szsamin/Nexys4DDRQuadcopter/README.md

# Nexys4DDRQuadcopter
Fully Functional Quadcopter over bluetooth control with RN42. We were not able to make the control system work well. But the basic functionality as all there.
