szsamin/Nexys4DDRQuadcopter/embsys.pdf

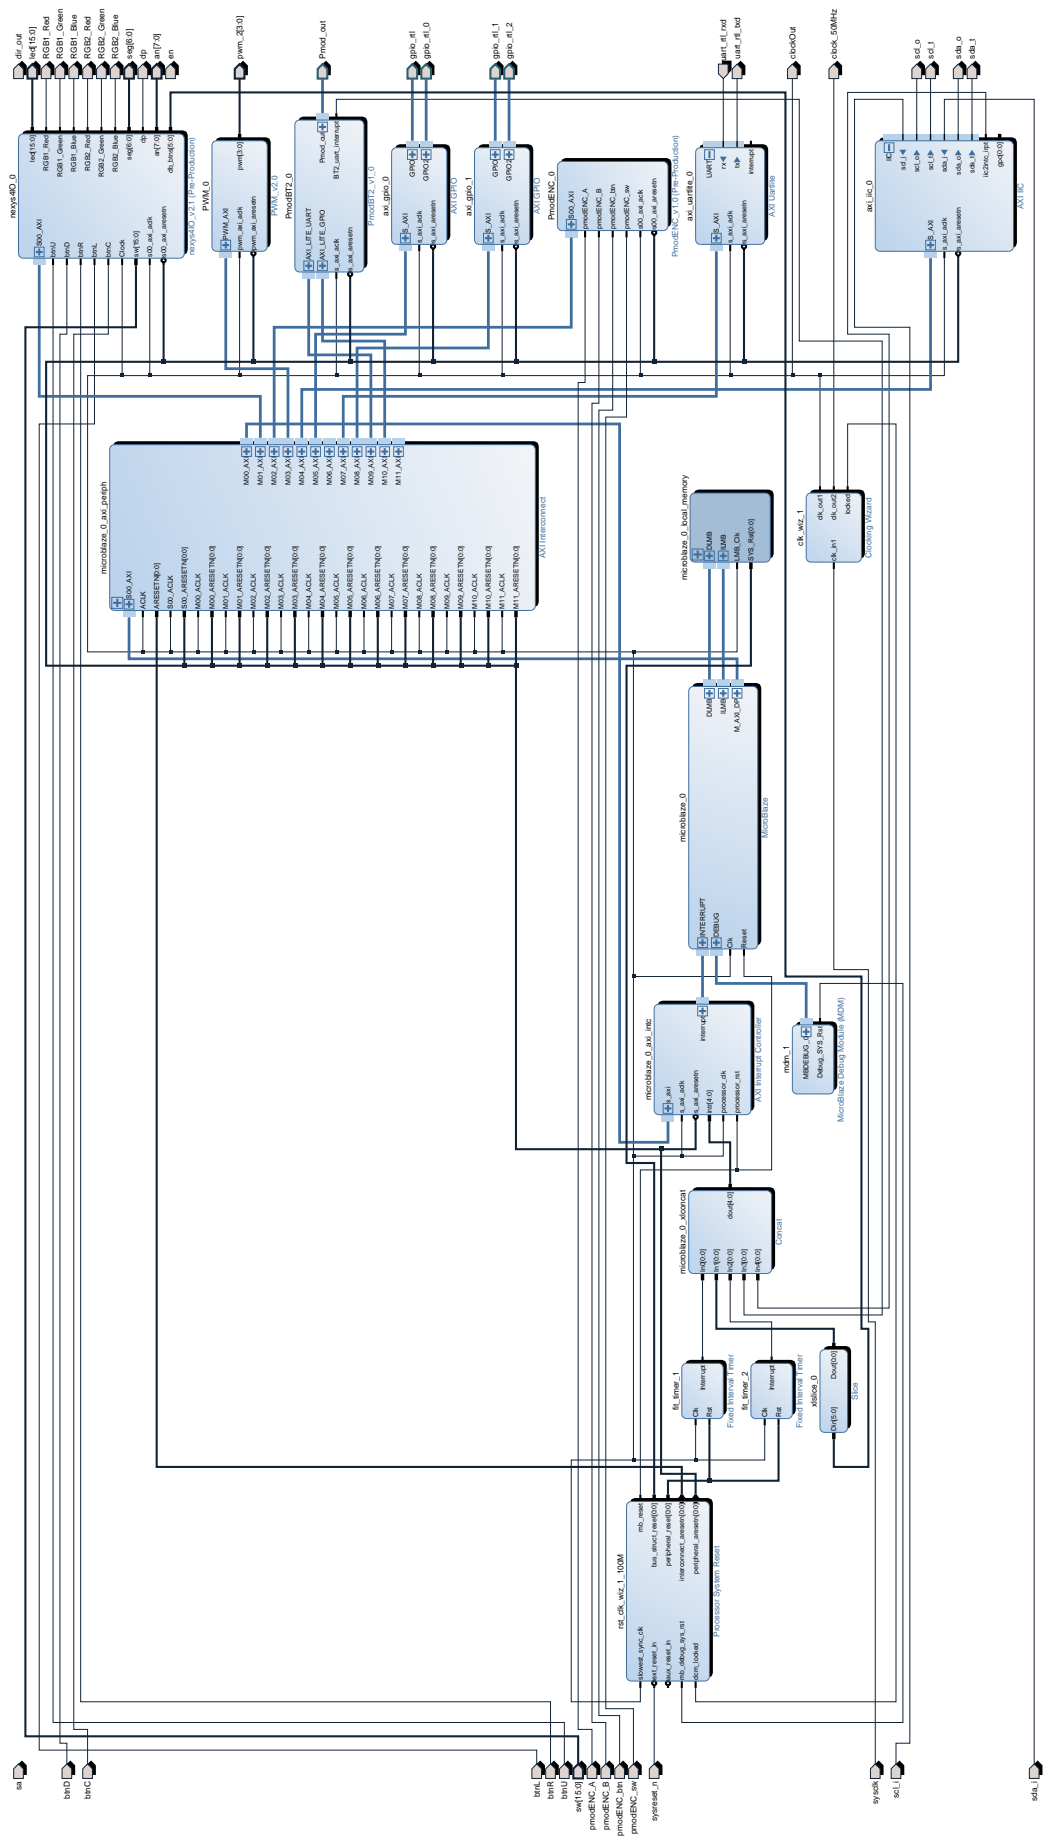
[picture p7: page 1]
PWM_0; PWM_v2.0; PWM_AXI; pwm[3:0] pwm_axi_aclk; pwm_axi_aresetn; PmodBT2_0; PmodBT2_v1_0; Pmod_out; AXI_LITE_UART; AXI_LITE_GPIO; BT2_uart_interrupt s_axi_aclk; s_axi_aresetn; PmodENC_0; PmodENC_v1.0 (Pre-Production); S00_AXI; pmodENC_A; pmodENC_B; pmodENC_btn; pmodENC_sw; s00_axi_aclk; s00_axi_aresetn; RGB1_Red RGB1_Green RGB1_Blue RGB2_Red RGB2_Green RGB2_Blue; axi_gpio_0; AXI GPIO; S_AXI GPIO; GPIO2; s_axi_aclk; axi_gpio_1; axi_iic_0; AXI IIC; S_AXI; IIC; scl_i; scl_o; scl_t; sda_i; sda_o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

MicroBlaze Debug Module (MDM)

AXI Interrupt Controller

Fixed Interval Timer

Processor System Reset
