szsamin/Nexys4DDRQuadcopter/sources_1/bd/embsys/hdl/embsys.v

//Copyright 1986-2016 Xilinx, Inc. All Rights Reserved.
//--------------------------------------------------------------------------------
//Tool Version: Vivado v.2016.2 (win64) Build 1577090 Thu Jun  2 16:32:40 MDT 2016
//Date        : Sat Mar 18 22:24:07 2017
//Host        : DESKTOP-9GRO23T running 64-bit major release  (build 9200)
//Command     : generate_target embsys.bd
//Design      : embsys
//Purpose     : IP block netlist
//--------------------------------------------------------------------------------
`timescale 1 ps / 1 ps

(* CORE_GENERATION_INFO = "embsys,IP_Integrator,{x_ipVendor=xilinx.com,x_ipLibrary=BlockDiagram,x_ipName=embsys,x_ipVersion=1.00.a,x_ipLanguage=VERILOG,numBlks=38,numReposBlks=23,numNonXlnxBlks=3,numHierBlks=15,maxHierDepth=1,numSysgenBlks=0,numHlsBlks=0,numHdlrefBlks=0,numPkgbdBlks=0,bdsource=USER,da_axi4_cnt=32,da_board_cnt=13,da_mb_cnt=1,synth_mode=Global}" *) (* HW_HANDOFF = "embsys.hwdef" *) 
module embsys
   (Pmod_out_pin10_i,
    Pmod_out_pin10_o,
    Pmod_out_pin10_t,
    Pmod_out_pin1_i,
    Pmod_out_pin1_o,
    Pmod_out_pin1_t,
    Pmod_out_pin2_i,
    Pmod_out_pin2_o,
    Pmod_out_pin2_t,
    Pmod_out_pin3_i,
    Pmod_out_pin3_o,
    Pmod_out_pin3_t,
    Pmod_out_pin4_i,
    Pmod_out_pin4_o,
    Pmod_out_pin4_t,
    Pmod_out_pin7_i,
    Pmod_out_pin7_o,
    Pmod_out_pin7_t,
    Pmod_out_pin8_i,
    Pmod_out_pin8_o,
    Pmod_out_pin8_t,
    Pmod_out_pin9_i,
    Pmod_out_pin9_o,
    Pmod_out_pin9_t,
    RGB1_Blue,
    RGB1_Green,
    RGB1_Red,
    RGB2_Blue,
    RGB2_Green,
    RGB2_Red,
    an,
    btnC,
    btnD,
    btnL,
    btnR,
    btnU,
    clockOut,
    clock_50MHz,
    dir_out,
    dp,
    en,
    gpio_rtl_0_tri_i,
    gpio_rtl_1_tri_i,
    gpio_rtl_2_tri_i,
    gpio_rtl_tri_i,
    led,
    pmodENC_A,
    pmodENC_B,
    pmodENC_btn,
    pmodENC_sw,
    pwm_2,
    sa,
    scl_i,
    scl_o,
    scl_t,
    sda_i,
    sda_o,
    sda_t,
    seg,
    sw,
    sysclk,
    sysreset_n,
    uart_rtl_rxd,
    uart_rtl_txd);
  input Pmod_out_pin10_i;
  output Pmod_out_pin10_o;
  output Pmod_out_pin10_t;
  input Pmod_out_pin1_i;
  output Pmod_out_pin1_o;
  output Pmod_out_pin1_t;
  input Pmod_out_pin2_i;
  output Pmod_out_pin2_o;
  output Pmod_out_pin2_t;
  input Pmod_out_pin3_i;
  output Pmod_out_pin3_o;
  output Pmod_out_pin3_t;
  input Pmod_out_pin4_i;
  output Pmod_out_pin4_o;
  output Pmod_out_pin4_t;
  input Pmod_out_pin7_i;
  output Pmod_out_pin7_o;
  output Pmod_out_pin7_t;
  input Pmod_out_pin8_i;
  output Pmod_out_pin8_o;
  output Pmod_out_pin8_t;
  input Pmod_out_pin9_i;
  output Pmod_out_pin9_o;
  output Pmod_out_pin9_t;
  output RGB1_Blue;
  output RGB1_Green;
  output RGB1_Red;
  output RGB2_Blue;
  output RGB2_Green;
  output RGB2_Red;
  output [7:0]an;
  input btnC;
  input btnD;
  input btnL;
  input btnR;
  input btnU;
  output clockOut;
  output clock_50MHz;
  output dir_out;
  output dp;
  output en;
  input [11:0]gpio_rtl_0_tri_i;
  input [11:0]gpio_rtl_1_tri_i;
  input [11:0]gpio_rtl_2_tri_i;
  input [11:0]gpio_rtl_tri_i;
  output [15:0]led;
  input pmodENC_A;
  input pmodENC_B;
  input pmodENC_btn;
  input pmodENC_sw;
  output [3:0]pwm_2;
  input sa;
  input scl_i;
  output scl_o;
  output scl_t;
  input sda_i;
  output sda_o;
  output sda_t;
  output [6:0]seg;
  input [15:0]sw;
  input sysclk;
  input sysreset_n;
  input uart_rtl_rxd;
  output uart_rtl_txd;

  wire [3:0]PWM_0_pwm;
  wire PmodBT2_0_BT2_uart_interrupt;
  wire PmodBT2_0_Pmod_out_PIN10_I;
  wire PmodBT2_0_Pmod_out_PIN10_O;
  wire PmodBT2_0_Pmod_out_PIN10_T;
  wire PmodBT2_0_Pmod_out_PIN1_I;
  wire PmodBT2_0_Pmod_out_PIN1_O;
  wire PmodBT2_0_Pmod_out_PIN1_T;
  wire PmodBT2_0_Pmod_out_PIN2_I;
  wire PmodBT2_0_Pmod_out_PIN2_O;
  wire PmodBT2_0_Pmod_out_PIN2_T;
  wire PmodBT2_0_Pmod_out_PIN3_I;
  wire PmodBT2_0_Pmod_out_PIN3_O;
  wire PmodBT2_0_Pmod_out_PIN3_T;
  wire PmodBT2_0_Pmod_out_PIN4_I;
  wire PmodBT2_0_Pmod_out_PIN4_O;
  wire PmodBT2_0_Pmod_out_PIN4_T;
  wire PmodBT2_0_Pmod_out_PIN7_I;
  wire PmodBT2_0_Pmod_out_PIN7_O;
  wire PmodBT2_0_Pmod_out_PIN7_T;
  wire PmodBT2_0_Pmod_out_PIN8_I;
  wire PmodBT2_0_Pmod_out_PIN8_O;
  wire PmodBT2_0_Pmod_out_PIN8_T;
  wire PmodBT2_0_Pmod_out_PIN9_I;
  wire PmodBT2_0_Pmod_out_PIN9_O;
  wire PmodBT2_0_Pmod_out_PIN9_T;
  wire [11:0]axi_gpio_0_GPIO2_TRI_I;
  wire [11:0]axi_gpio_0_GPIO_TRI_I;
  wire [11:0]axi_gpio_1_GPIO2_TRI_I;
  wire [11:0]axi_gpio_1_GPIO_TRI_I;
  wire axi_iic_0_iic2intc_irpt;
  wire axi_iic_0_scl_o;
  wire axi_iic_0_scl_t;
  wire axi_iic_0_sda_o;
  wire axi_iic_0_sda_t;
  wire axi_uartlite_0_tx;
  wire [0:0]\^btnC ;
  wire btnC_1;
  wire btnD_1;
  wire btnL_1;
  wire btnR_1;
  wire btnU_1;
  wire clk_in1_1;
  wire clk_wiz_1_clk_out2;
  wire clk_wiz_1_locked;
  wire ext_reset_in_1;
  wire fit_timer_1_Interrupt;
  wire fit_timer_2_Interrupt;
  wire mdm_1_debug_sys_rst;
  wire microblaze_0_Clk;
  wire [31:0]microblaze_0_axi_dp_ARADDR;
  wire [2:0]microblaze_0_axi_dp_ARPROT;
  wire [0:0]microblaze_0_axi_dp_ARREADY;
  wire microblaze_0_axi_dp_ARVALID;
  wire [31:0]microblaze_0_axi_dp_AWADDR;
  wire [2:0]microblaze_0_axi_dp_AWPROT;
  wire [0:0]microblaze_0_axi_dp_AWREADY;
  wire microblaze_0_axi_dp_AWVALID;
  wire microblaze_0_axi_dp_BREADY;
  wire [1:0]microblaze_0_axi_dp_BRESP;
  wire [0:0]microblaze_0_axi_dp_BVALID;
  wire [31:0]microblaze_0_axi_dp_RDATA;
  wire microblaze_0_axi_dp_RREADY;
  wire [1:0]microblaze_0_axi_dp_RRESP;
  wire [0:0]microblaze_0_axi_dp_RVALID;
  wire [31:0]microblaze_0_axi_dp_WDATA;
  wire [0:0]microblaze_0_axi_dp_WREADY;
  wire [3:0]microblaze_0_axi_dp_WSTRB;
  wire microblaze_0_axi_dp_WVALID;
  wire [31:0]microblaze_0_axi_periph_M01_AXI_ARADDR;
  wire [2:0]microblaze_0_axi_periph_M01_AXI_ARPROT;
  wire microblaze_0_axi_periph_M01_AXI_ARREADY;
  wire microblaze_0_axi_periph_M01_AXI_ARVALID;
  wire [31:0]microblaze_0_axi_periph_M01_AXI_AWADDR;
  wire [2:0]microblaze_0_axi_periph_M01_AXI_AWPROT;
  wire microblaze_0_axi_periph_M01_AXI_AWREADY;
  wire microblaze_0_axi_periph_M01_AXI_AWVALID;
  wire microblaze_0_axi_periph_M01_AXI_BREADY;
  wire [1:0]microblaze_0_axi_periph_M01_AXI_BRESP;
  wire microblaze_0_axi_periph_M01_AXI_BVALID;
  wire [31:0]microblaze_0_axi_periph_M01_AXI_RDATA;
  wire microblaze_0_axi_periph_M01_AXI_RREADY;
  wire [1:0]microblaze_0_axi_periph_M01_AXI_RRESP;
  wire microblaze_0_axi_periph_M01_AXI_RVALID;
  wire [31:0]microblaze_0_axi_periph_M01_AXI_WDATA;
  wire microblaze_0_axi_periph_M01_AXI_WREADY;
  wire [3:0]microblaze_0_axi_periph_M01_AXI_WSTRB;
  wire microblaze_0_axi_periph_M01_AXI_WVALID;
  wire [31:0]microblaze_0_axi_periph_M02_AXI_ARADDR;
  wire [2:0]microblaze_0_axi_periph_M02_AXI_ARPROT;
  wire microblaze_0_axi_periph_M02_AXI_ARREADY;
  wire [0:0]microblaze_0_axi_periph_M02_AXI_ARVALID;
  wire [31:0]microblaze_0_axi_periph_M02_AXI_AWADDR;
  wire [2:0]microblaze_0_axi_periph_M02_AXI_AWPROT;
  wire microblaze_0_axi_periph_M02_AXI_AWREADY;
  wire [0:0]microblaze_0_axi_periph_M02_AXI_AWVALID;
  wire [0:0]microblaze_0_axi_periph_M02_AXI_BREADY;
  wire [1:0]microblaze_0_axi_periph_M02_AXI_BRESP;
  wire microblaze_0_axi_periph_M02_AXI_BVALID;
  wire [31:0]microblaze_0_axi_periph_M02_AXI_RDATA;
  wire [0:0]microblaze_0_axi_periph_M02_AXI_RREADY;
  wire [1:0]microblaze_0_axi_periph_M02_AXI_RRESP;
  wire microblaze_0_axi_periph_M02_AXI_RVALID;
  wire [31:0]microblaze_0_axi_periph_M02_AXI_WDATA;
  wire microblaze_0_axi_periph_M02_AXI_WREADY;
  wire [3:0]microblaze_0_axi_periph_M02_AXI_WSTRB;
  wire [0:0]microblaze_0_axi_periph_M02_AXI_WVALID;
  wire [31:0]microblaze_0_axi_periph_M03_AXI_ARADDR;
  wire [2:0]microblaze_0_axi_periph_M03_AXI_ARPROT;
  wire microblaze_0_axi_periph_M03_AXI_ARREADY;
  wire microblaze_0_axi_periph_M03_AXI_ARVALID;
  wire [31:0]microblaze_0_axi_periph_M03_AXI_AWADDR;
  wire [2:0]microblaze_0_axi_periph_M03_AXI_AWPROT;
  wire microblaze_0_axi_periph_M03_AXI_AWREADY;
  wire microblaze_0_axi_periph_M03_AXI_AWVALID;
  wire microblaze_0_axi_periph_M03_AXI_BREADY;
  wire [1:0]microblaze_0_axi_periph_M03_AXI_BRESP;
  wire microblaze_0_axi_periph_M03_AXI_BVALID;
  wire [31:0]microblaze_0_axi_periph_M03_AXI_RDATA;
  wire microblaze_0_axi_periph_M03_AXI_RREADY;
  wire [1:0]microblaze_0_axi_periph_M03_AXI_RRESP;
  wire microblaze_0_axi_periph_M03_AXI_RVALID;
  wire [31:0]microblaze_0_axi_periph_M03_AXI_WDATA;
  wire microblaze_0_axi_periph_M03_AXI_WREADY;
  wire [3:0]microblaze_0_axi_periph_M03_AXI_WSTRB;
  wire microblaze_0_axi_periph_M03_AXI_WVALID;
  wire [31:0]microblaze_0_axi_periph_M04_AXI_ARADDR;
  wire microblaze_0_axi_periph_M04_AXI_ARREADY;
  wire microblaze_0_axi_periph_M04_AXI_ARVALID;
  wire [31:0]microblaze_0_axi_periph_M04_AXI_AWADDR;
  wire microblaze_0_axi_periph_M04_AXI_AWREADY;
  wire microblaze_0_axi_periph_M04_AXI_AWVALID;
  wire microblaze_0_axi_periph_M04_AXI_BREADY;
  wire [1:0]microblaze_0_axi_periph_M04_AXI_BRESP;
  wire microblaze_0_axi_periph_M04_AXI_BVALID;
  wire [31:0]microblaze_0_axi_periph_M04_AXI_RDATA;
  wire microblaze_0_axi_periph_M04_AXI_RREADY;
  wire [1:0]microblaze_0_axi_periph_M04_AXI_RRESP;
  wire microblaze_0_axi_periph_M04_AXI_RVALID;
  wire [31:0]microblaze_0_axi_periph_M04_AXI_WDATA;
  wire microblaze_0_axi_periph_M04_AXI_WREADY;
  wire [3:0]microblaze_0_axi_periph_M04_AXI_WSTRB;
  wire microblaze_0_axi_periph_M04_AXI_WVALID;
  wire [31:0]microblaze_0_axi_periph_M05_AXI_ARADDR;
  wire microblaze_0_axi_periph_M05_AXI_ARREADY;
  wire microblaze_0_axi_periph_M05_AXI_ARVALID;
  wire [31:0]microblaze_0_axi_periph_M05_AXI_AWADDR;
  wire microblaze_0_axi_periph_M05_AXI_AWREADY;
  wire microblaze_0_axi_periph_M05_AXI_AWVALID;
  wire microblaze_0_axi_periph_M05_AXI_BREADY;
  wire [1:0]microblaze_0_axi_periph_M05_AXI_BRESP;
  wire microblaze_0_axi_periph_M05_AXI_BVALID;
  wire [31:0]microblaze_0_axi_periph_M05_AXI_RDATA;
  wire microblaze_0_axi_periph_M05_AXI_RREADY;
  wire [1:0]microblaze_0_axi_periph_M05_AXI_RRESP;
  wire microblaze_0_axi_periph_M05_AXI_RVALID;
  wire [31:0]microblaze_0_axi_periph_M05_AXI_WDATA;
  wire microblaze_0_axi_periph_M05_AXI_WREADY;
  wire [3:0]microblaze_0_axi_periph_M05_AXI_WSTRB;
  wire microblaze_0_axi_periph_M05_AXI_WVALID;
  wire [31:0]microblaze_0_axi_periph_M07_AXI_ARADDR;
  wire microblaze_0_axi_periph_M07_AXI_ARREADY;
  wire [0:0]microblaze_0_axi_periph_M07_AXI_ARVALID;
  wire [31:0]microblaze_0_axi_periph_M07_AXI_AWADDR;
  wire microblaze_0_axi_periph_M07_AXI_AWREADY;
  wire [0:0]microblaze_0_axi_periph_M07_AXI_AWVALID;
  wire [0:0]microblaze_0_axi_periph_M07_AXI_BREADY;
  wire [1:0]microblaze_0_axi_periph_M07_AXI_BRESP;
  wire microblaze_0_axi_periph_M07_AXI_BVALID;
  wire [31:0]microblaze_0_axi_periph_M07_AXI_RDATA;
  wire [0:0]microblaze_0_axi_periph_M07_AXI_RREADY;
  wire [1:0]microblaze_0_axi_periph_M07_AXI_RRESP;
  wire microblaze_0_axi_periph_M07_AXI_RVALID;
  wire [31:0]microblaze_0_axi_periph_M07_AXI_WDATA;
  wire microblaze_0_axi_periph_M07_AXI_WREADY;
  wire [3:0]microblaze_0_axi_periph_M07_AXI_WSTRB;
  wire [0:0]microblaze_0_axi_periph_M07_AXI_WVALID;
  wire [31:0]microblaze_0_axi_periph_M08_AXI_ARADDR;
  wire microblaze_0_axi_periph_M08_AXI_ARREADY;
  wire microblaze_0_axi_periph_M08_AXI_ARVALID;
  wire [31:0]microblaze_0_axi_periph_M08_AXI_AWADDR;
  wire microblaze_0_axi_periph_M08_AXI_AWREADY;
  wire microblaze_0_axi_periph_M08_AXI_AWVALID;
  wire microblaze_0_axi_periph_M08_AXI_BREADY;
  wire [1:0]microblaze_0_axi_periph_M08_AXI_BRESP;
  wire microblaze_0_axi_periph_M08_AXI_BVALID;
  wire [31:0]microblaze_0_axi_periph_M08_AXI_RDATA;
  wire microblaze_0_axi_periph_M08_AXI_RREADY;
  wire [1:0]microblaze_0_axi_periph_M08_AXI_RRESP;
  wire microblaze_0_axi_periph_M08_AXI_RVALID;
  wire [31:0]microblaze_0_axi_periph_M08_AXI_WDATA;
  wire microblaze_0_axi_periph_M08_AXI_WREADY;
  wire [3:0]microblaze_0_axi_periph_M08_AXI_WSTRB;
  wire microblaze_0_axi_periph_M08_AXI_WVALID;
  wire [31:0]microblaze_0_axi_periph_M09_AXI_ARADDR;
  wire microblaze_0_axi_periph_M09_AXI_ARREADY;
  wire microblaze_0_axi_periph_M09_AXI_ARVALID;
  wire [31:0]microblaze_0_axi_periph_M09_AXI_AWADDR;
  wire microblaze_0_axi_periph_M09_AXI_AWREADY;
  wire microblaze_0_axi_periph_M09_AXI_AWVALID;
  wire microblaze_0_axi_periph_M09_AXI_BREADY;
  wire [1:0]microblaze_0_axi_periph_M09_AXI_BRESP;
  wire microblaze_0_axi_periph_M09_AXI_BVALID;
  wire [31:0]microblaze_0_axi_periph_M09_AXI_RDATA;
  wire microblaze_0_axi_periph_M09_AXI_RREADY;
  wire [1:0]microblaze_0_axi_periph_M09_AXI_RRESP;
  wire microblaze_0_axi_periph_M09_AXI_RVALID;
  wire [31:0]microblaze_0_axi_periph_M09_AXI_WDATA;
  wire microblaze_0_axi_periph_M09_AXI_WREADY;
  wire [3:0]microblaze_0_axi_periph_M09_AXI_WSTRB;
  wire microblaze_0_axi_periph_M09_AXI_WVALID;
  wire [31:0]microblaze_0_axi_periph_M10_AXI_ARADDR;
  wire microblaze_0_axi_periph_M10_AXI_ARREADY;
  wire microblaze_0_axi_periph_M10_AXI_ARVALID;
  wire [31:0]microblaze_0_axi_periph_M10_AXI_AWADDR;
  wire microblaze_0_axi_periph_M10_AXI_AWREADY;
  wire microblaze_0_axi_periph_M10_AXI_AWVALID;
  wire microblaze_0_axi_periph_M10_AXI_BREADY;
  wire [1:0]microblaze_0_axi_periph_M10_AXI_BRESP;
  wire microblaze_0_axi_periph_M10_AXI_BVALID;
  wire [31:0]microblaze_0_axi_periph_M10_AXI_RDATA;
  wire microblaze_0_axi_periph_M10_AXI_RREADY;
  wire [1:0]microblaze_0_axi_periph_M10_AXI_RRESP;
  wire microblaze_0_axi_periph_M10_AXI_RVALID;
  wire [31:0]microblaze_0_axi_periph_M10_AXI_WDATA;
  wire microblaze_0_axi_periph_M10_AXI_WREADY;
  wire [3:0]microblaze_0_axi_periph_M10_AXI_WSTRB;
  wire microblaze_0_axi_periph_M10_AXI_WVALID;
  wire microblaze_0_debug_CAPTURE;
  wire microblaze_0_debug_CLK;
  wire [0:7]microblaze_0_debug_REG_EN;
  wire microblaze_0_debug_RST;
  wire microblaze_0_debug_SHIFT;
  wire microblaze_0_debug_TDI;
  wire microblaze_0_debug_TDO;
  wire microblaze_0_debug_UPDATE;
  wire [0:31]microblaze_0_dlmb_1_ABUS;
  wire microblaze_0_dlmb_1_ADDRSTROBE;
  wire [0:3]microblaze_0_dlmb_1_BE;
  wire microblaze_0_dlmb_1_CE;
  wire [0:31]microblaze_0_dlmb_1_READDBUS;
  wire microblaze_0_dlmb_1_READSTROBE;
  wire microblaze_0_dlmb_1_READY;
  wire microblaze_0_dlmb_1_UE;
  wire microblaze_0_dlmb_1_WAIT;
  wire [0:31]microblaze_0_dlmb_1_WRITEDBUS;
  wire microblaze_0_dlmb_1_WRITESTROBE;
  wire [0:31]microblaze_0_ilmb_1_ABUS;
  wire microblaze_0_ilmb_1_ADDRSTROBE;
  wire microblaze_0_ilmb_1_CE;
  wire [0:31]microblaze_0_ilmb_1_READDBUS;
  wire microblaze_0_ilmb_1_READSTROBE;
  wire microblaze_0_ilmb_1_READY;
  wire microblaze_0_ilmb_1_UE;
  wire microblaze_0_ilmb_1_WAIT;
  wire [31:0]microblaze_0_intc_axi_ARADDR;
  wire microblaze_0_intc_axi_ARREADY;
  wire microblaze_0_intc_axi_ARVALID;
  wire [31:0]microblaze_0_intc_axi_AWADDR;
  wire microblaze_0_intc_axi_AWREADY;
  wire microblaze_0_intc_axi_AWVALID;
  wire microblaze_0_intc_axi_BREADY;
  wire [1:0]microblaze_0_intc_axi_BRESP;
  wire microblaze_0_intc_axi_BVALID;
  wire [31:0]microblaze_0_intc_axi_RDATA;
  wire microblaze_0_intc_axi_RREADY;
  wire [1:0]microblaze_0_intc_axi_RRESP;
  wire microblaze_0_intc_axi_RVALID;
  wire [31:0]microblaze_0_intc_axi_WDATA;
  wire microblaze_0_intc_axi_WREADY;
  wire [3:0]microblaze_0_intc_axi_WSTRB;
  wire microblaze_0_intc_axi_WVALID;
  wire [0:1]microblaze_0_interrupt_ACK;
  wire [31:0]microblaze_0_interrupt_ADDRESS;
  wire microblaze_0_interrupt_INTERRUPT;
  wire [4:0]microblaze_0_intr;
  wire nexys4IO_0_RGB1_Blue;
  wire nexys4IO_0_RGB1_Green;
  wire nexys4IO_0_RGB1_Red;
  wire nexys4IO_0_RGB2_Blue;
  wire nexys4IO_0_RGB2_Green;
  wire nexys4IO_0_RGB2_Red;
  wire [7:0]nexys4IO_0_an;
  wire [5:0]nexys4IO_0_db_btns;
  wire nexys4IO_0_dp;
  wire [15:0]nexys4IO_0_led;
  wire [6:0]nexys4IO_0_seg;
  wire pmodENC_A_1;
  wire pmodENC_B_1;
  wire pmodENC_btn_1;
  wire pmodENC_sw_1;
  wire [0:0]rst_clk_wiz_1_100M_bus_struct_reset;
  wire [0:0]rst_clk_wiz_1_100M_interconnect_aresetn;
  wire rst_clk_wiz_1_100M_mb_reset;
  wire [0:0]rst_clk_wiz_1_100M_peripheral_aresetn;
  wire [0:0]rst_clk_wiz_1_100M_peripheral_reset;
  wire scl_i_1;
  wire sda_i_1;
  wire [15:0]sw_1;
  wire uart_rtl_rxd_1;

  assign PmodBT2_0_Pmod_out_PIN10_I = Pmod_out_pin10_i;
  assign PmodBT2_0_Pmod_out_PIN1_I = Pmod_out_pin1_i;
  assign PmodBT2_0_Pmod_out_PIN2_I = Pmod_out_pin2_i;
  assign PmodBT2_0_Pmod_out_PIN3_I = Pmod_out_pin3_i;
  assign PmodBT2_0_Pmod_out_PIN4_I = Pmod_out_pin4_i;
  assign PmodBT2_0_Pmod_out_PIN7_I = Pmod_out_pin7_i;
  assign PmodBT2_0_Pmod_out_PIN8_I = Pmod_out_pin8_i;
  assign PmodBT2_0_Pmod_out_PIN9_I = Pmod_out_pin9_i;
  assign Pmod_out_pin10_o = PmodBT2_0_Pmod_out_PIN10_O;
  assign Pmod_out_pin10_t = PmodBT2_0_Pmod_out_PIN10_T;
  assign Pmod_out_pin1_o = PmodBT2_0_Pmod_out_PIN1_O;
  assign Pmod_out_pin1_t = PmodBT2_0_Pmod_out_PIN1_T;
  assign Pmod_out_pin2_o = PmodBT2_0_Pmod_out_PIN2_O;
  assign Pmod_out_pin2_t = PmodBT2_0_Pmod_out_PIN2_T;
  assign Pmod_out_pin3_o = PmodBT2_0_Pmod_out_PIN3_O;
  assign Pmod_out_pin3_t = PmodBT2_0_Pmod_out_PIN3_T;
  assign Pmod_out_pin4_o = PmodBT2_0_Pmod_out_PIN4_O;
  assign Pmod_out_pin4_t = PmodBT2_0_Pmod_out_PIN4_T;
  assign Pmod_out_pin7_o = PmodBT2_0_Pmod_out_PIN7_O;
  assign Pmod_out_pin7_t = PmodBT2_0_Pmod_out_PIN7_T;
  assign Pmod_out_pin8_o = PmodBT2_0_Pmod_out_PIN8_O;
  assign Pmod_out_pin8_t = PmodBT2_0_Pmod_out_PIN8_T;
  assign Pmod_out_pin9_o = PmodBT2_0_Pmod_out_PIN9_O;
  assign Pmod_out_pin9_t = PmodBT2_0_Pmod_out_PIN9_T;
  assign RGB1_Blue = nexys4IO_0_RGB1_Blue;
  assign RGB1_Green = nexys4IO_0_RGB1_Green;
  assign RGB1_Red = nexys4IO_0_RGB1_Red;
  assign RGB2_Blue = nexys4IO_0_RGB2_Blue;
  assign RGB2_Green = nexys4IO_0_RGB2_Green;
  assign RGB2_Red = nexys4IO_0_RGB2_Red;
  assign an[7:0] = nexys4IO_0_an;
  assign axi_gpio_0_GPIO2_TRI_I = gpio_rtl_0_tri_i[11:0];
  assign axi_gpio_0_GPIO_TRI_I = gpio_rtl_tri_i[11:0];
  assign axi_gpio_1_GPIO2_TRI_I = gpio_rtl_2_tri_i[11:0];
  assign axi_gpio_1_GPIO_TRI_I = gpio_rtl_1_tri_i[11:0];
  assign btnC_1 = btnC;
  assign btnD_1 = btnD;
  assign btnL_1 = btnL;
  assign btnR_1 = btnR;
  assign btnU_1 = btnU;
  assign clk_in1_1 = sysclk;
  assign clockOut = microblaze_0_Clk;
  assign clock_50MHz = clk_wiz_1_clk_out2;
  assign dp = nexys4IO_0_dp;
  assign ext_reset_in_1 = sysreset_n;
  assign led[15:0] = nexys4IO_0_led;
  assign pmodENC_A_1 = pmodENC_A;
  assign pmodENC_B_1 = pmodENC_B;
  assign pmodENC_btn_1 = pmodENC_btn;
  assign pmodENC_sw_1 = pmodENC_sw;
  assign pwm_2[3:0] = PWM_0_pwm;
  assign scl_i_1 = scl_i;
  assign scl_o = axi_iic_0_scl_o;
  assign scl_t = axi_iic_0_scl_t;
  assign sda_i_1 = sda_i;
  assign sda_o = axi_iic_0_sda_o;
  assign sda_t = axi_iic_0_sda_t;
  assign seg[6:0] = nexys4IO_0_seg;
  assign sw_1 = sw[15:0];
  assign uart_rtl_rxd_1 = uart_rtl_rxd;
  assign uart_rtl_txd = axi_uartlite_0_tx;
  embsys_PWM_0_0 PWM_0
       (.pwm(PWM_0_pwm),
        .pwm_axi_aclk(microblaze_0_Clk),
        .pwm_axi_araddr(microblaze_0_axi_periph_M03_AXI_ARADDR[6:0]),
        .pwm_axi_aresetn(rst_clk_wiz_1_100M_peripheral_aresetn),
        .pwm_axi_arprot(microblaze_0_axi_periph_M03_AXI_ARPROT),
        .pwm_axi_arready(microblaze_0_axi_periph_M03_AXI_ARREADY),
        .pwm_axi_arvalid(microblaze_0_axi_periph_M03_AXI_ARVALID),
        .pwm_axi_awaddr(microblaze_0_axi_periph_M03_AXI_AWADDR[6:0]),
        .pwm_axi_awprot(microblaze_0_axi_periph_M03_AXI_AWPROT),
        .pwm_axi_awready(microblaze_0_axi_periph_M03_AXI_AWREADY),
        .pwm_axi_awvalid(microblaze_0_axi_periph_M03_AXI_AWVALID),
        .pwm_axi_bready(microblaze_0_axi_periph_M03_AXI_BREADY),
        .pwm_axi_bresp(microblaze_0_axi_periph_M03_AXI_BRESP),
        .pwm_axi_bvalid(microblaze_0_axi_periph_M03_AXI_BVALID),
        .pwm_axi_rdata(microblaze_0_axi_periph_M03_AXI_RDATA),
        .pwm_axi_rready(microblaze_0_axi_periph_M03_AXI_RREADY),
        .pwm_axi_rresp(microblaze_0_axi_periph_M03_AXI_RRESP),
        .pwm_axi_rvalid(microblaze_0_axi_periph_M03_AXI_RVALID),
        .pwm_axi_wdata(microblaze_0_axi_periph_M03_AXI_WDATA),
        .pwm_axi_wready(microblaze_0_axi_periph_M03_AXI_WREADY),
        .pwm_axi_wstrb(microblaze_0_axi_periph_M03_AXI_WSTRB),
        .pwm_axi_wvalid(microblaze_0_axi_periph_M03_AXI_WVALID));
  embsys_PmodBT2_0_0 PmodBT2_0
       (.AXI_LITE_GPIO_araddr(microblaze_0_axi_periph_M10_AXI_ARADDR[8:0]),
        .AXI_LITE_GPIO_arready(microblaze_0_axi_periph_M10_AXI_ARREADY),
        .AXI_LITE_GPIO_arvalid(microblaze_0_axi_periph_M10_AXI_ARVALID),
        .AXI_LITE_GPIO_awaddr(microblaze_0_axi_periph_M10_AXI_AWADDR[8:0]),
        .AXI_LITE_GPIO_awready(microblaze_0_axi_periph_M10_AXI_AWREADY),
        .AXI_LITE_GPIO_awvalid(microblaze_0_axi_periph_M10_AXI_AWVALID),
        .AXI_LITE_GPIO_bready(microblaze_0_axi_periph_M10_AXI_BREADY),
        .AXI_LITE_GPIO_bresp(microblaze_0_axi_periph_M10_AXI_BRESP),
        .AXI_LITE_GPIO_bvalid(microblaze_0_axi_periph_M10_AXI_BVALID),
        .AXI_LITE_GPIO_rdata(microblaze_0_axi_periph_M10_AXI_RDATA),
        .AXI_LITE_GPIO_rready(microblaze_0_axi_periph_M10_AXI_RREADY),
        .AXI_LITE_GPIO_rresp(microblaze_0_axi_periph_M10_AXI_RRESP),
        .AXI_LITE_GPIO_rvalid(microblaze_0_axi_periph_M10_AXI_RVALID),
        .AXI_LITE_GPIO_wdata(microblaze_0_axi_periph_M10_AXI_WDATA),
        .AXI_LITE_GPIO_wready(microblaze_0_axi_periph_M10_AXI_WREADY),
        .AXI_LITE_GPIO_wstrb(microblaze_0_axi_periph_M10_AXI_WSTRB),
        .AXI_LITE_GPIO_wvalid(microblaze_0_axi_periph_M10_AXI_WVALID),
        .AXI_LITE_UART_araddr(microblaze_0_axi_periph_M09_AXI_ARADDR[12:0]),
        .AXI_LITE_UART_arready(microblaze_0_axi_periph_M09_AXI_ARREADY),
        .AXI_LITE_UART_arvalid(microblaze_0_axi_periph_M09_AXI_ARVALID),
        .AXI_LITE_UART_awaddr(microblaze_0_axi_periph_M09_AXI_AWADDR[12:0]),
        .AXI_LITE_UART_awready(microblaze_0_axi_periph_M09_AXI_AWREADY),
        .AXI_LITE_UART_awvalid(microblaze_0_axi_periph_M09_AXI_AWVALID),
        .AXI_LITE_UART_bready(microblaze_0_axi_periph_M09_AXI_BREADY),
        .AXI_LITE_UART_bresp(microblaze_0_axi_periph_M09_AXI_BRESP),
        .AXI_LITE_UART_bvalid(microblaze_0_axi_periph_M09_AXI_BVALID),
        .AXI_LITE_UART_rdata(microblaze_0_axi_periph_M09_AXI_RDATA),
        .AXI_LITE_UART_rready(microblaze_0_axi_periph_M09_AXI_RREADY),
        .AXI_LITE_UART_rresp(microblaze_0_axi_periph_M09_AXI_RRESP),
        .AXI_LITE_UART_rvalid(microblaze_0_axi_periph_M09_AXI_RVALID),
        .AXI_LITE_UART_wdata(microblaze_0_axi_periph_M09_AXI_WDATA),
        .AXI_LITE_UART_wready(microblaze_0_axi_periph_M09_AXI_WREADY),
        .AXI_LITE_UART_wstrb(microblaze_0_axi_periph_M09_AXI_WSTRB),
        .AXI_LITE_UART_wvalid(microblaze_0_axi_periph_M09_AXI_WVALID),
        .BT2_uart_interrupt(PmodBT2_0_BT2_uart_interrupt),
        .Pmod_out_pin10_i(PmodBT2_0_Pmod_out_PIN10_I),
        .Pmod_out_pin10_o(PmodBT2_0_Pmod_out_PIN10_O),
        .Pmod_out_pin10_t(PmodBT2_0_Pmod_out_PIN10_T),
        .Pmod_out_pin1_i(PmodBT2_0_Pmod_out_PIN1_I),
        .Pmod_out_pin1_o(PmodBT2_0_Pmod_out_PIN1_O),
        .Pmod_out_pin1_t(PmodBT2_0_Pmod_out_PIN1_T),
        .Pmod_out_pin2_i(PmodBT2_0_Pmod_out_PIN2_I),
        .Pmod_out_pin2_o(PmodBT2_0_Pmod_out_PIN2_O),
        .Pmod_out_pin2_t(PmodBT2_0_Pmod_out_PIN2_T),
        .Pmod_out_pin3_i(PmodBT2_0_Pmod_out_PIN3_I),
        .Pmod_out_pin3_o(PmodBT2_0_Pmod_out_PIN3_O),
        .Pmod_out_pin3_t(PmodBT2_0_Pmod_out_PIN3_T),
        .Pmod_out_pin4_i(PmodBT2_0_Pmod_out_PIN4_I),
        .Pmod_out_pin4_o(PmodBT2_0_Pmod_out_PIN4_O),
        .Pmod_out_pin4_t(PmodBT2_0_Pmod_out_PIN4_T),
        .Pmod_out_pin7_i(PmodBT2_0_Pmod_out_PIN7_I),
        .Pmod_out_pin7_o(PmodBT2_0_Pmod_out_PIN7_O),
        .Pmod_out_pin7_t(PmodBT2_0_Pmod_out_PIN7_T),
        .Pmod_out_pin8_i(PmodBT2_0_Pmod_out_PIN8_I),
        .Pmod_out_pin8_o(PmodBT2_0_Pmod_out_PIN8_O),
        .Pmod_out_pin8_t(PmodBT2_0_Pmod_out_PIN8_T),
        .Pmod_out_pin9_i(PmodBT2_0_Pmod_out_PIN9_I),
        .Pmod_out_pin9_o(PmodBT2_0_Pmod_out_PIN9_O),
        .Pmod_out_pin9_t(PmodBT2_0_Pmod_out_PIN9_T),
        .s_axi_aclk(microblaze_0_Clk),
        .s_axi_aresetn(rst_clk_wiz_1_100M_peripheral_aresetn));
  embsys_PmodENC_0_0 PmodENC_0
       (.pmodENC_A(pmodENC_A_1),
        .pmodENC_B(pmodENC_B_1),
        .pmodENC_btn(pmodENC_btn_1),
        .pmodENC_sw(pmodENC_sw_1),
        .s00_axi_aclk(microblaze_0_Clk),
        .s00_axi_araddr(microblaze_0_axi_periph_M02_AXI_ARADDR[3:0]),
        .s00_axi_aresetn(rst_clk_wiz_1_100M_peripheral_aresetn),
        .s00_axi_arprot(microblaze_0_axi_periph_M02_AXI_ARPROT),
        .s00_axi_arready(microblaze_0_axi_periph_M02_AXI_ARREADY),
        .s00_axi_arvalid(microblaze_0_axi_periph_M02_AXI_ARVALID),
        .s00_axi_awaddr(microblaze_0_axi_periph_M02_AXI_AWADDR[3:0]),
        .s00_axi_awprot(microblaze_0_axi_periph_M02_AXI_AWPROT),
        .s00_axi_awready(microblaze_0_axi_periph_M02_AXI_AWREADY),
        .s00_axi_awvalid(microblaze_0_axi_periph_M02_AXI_AWVALID),
        .s00_axi_bready(microblaze_0_axi_periph_M02_AXI_BREADY),
        .s00_axi_bresp(microblaze_0_axi_periph_M02_AXI_BRESP),
        .s00_axi_bvalid(microblaze_0_axi_periph_M02_AXI_BVALID),
        .s00_axi_rdata(microblaze_0_axi_periph_M02_AXI_RDATA),
        .s00_axi_rready(microblaze_0_axi_periph_M02_AXI_RREADY),
        .s00_axi_rresp(microblaze_0_axi_periph_M02_AXI_RRESP),
        .s00_axi_rvalid(microblaze_0_axi_periph_M02_AXI_RVALID),
        .s00_axi_wdata(microblaze_0_axi_periph_M02_AXI_WDATA),
        .s00_axi_wready(microblaze_0_axi_periph_M02_AXI_WREADY),
        .s00_axi_wstrb(microblaze_0_axi_periph_M02_AXI_WSTRB),
        .s00_axi_wvalid(microblaze_0_axi_periph_M02_AXI_WVALID));
  embsys_axi_gpio_0_0 axi_gpio_0
       (.gpio2_io_i(axi_gpio_0_GPIO2_TRI_I),
        .gpio_io_i(axi_gpio_0_GPIO_TRI_I),
        .s_axi_aclk(microblaze_0_Clk),
        .s_axi_araddr(microblaze_0_axi_periph_M05_AXI_ARADDR[8:0]),
        .s_axi_aresetn(rst_clk_wiz_1_100M_peripheral_aresetn),
        .s_axi_arready(microblaze_0_axi_periph_M05_AXI_ARREADY),
        .s_axi_arvalid(microblaze_0_axi_periph_M05_AXI_ARVALID),
        .s_axi_awaddr(microblaze_0_axi_periph_M05_AXI_AWADDR[8:0]),
        .s_axi_awready(microblaze_0_axi_periph_M05_AXI_AWREADY),
        .s_axi_awvalid(microblaze_0_axi_periph_M05_AXI_AWVALID),
        .s_axi_bready(microblaze_0_axi_periph_M05_AXI_BREADY),
        .s_axi_bresp(microblaze_0_axi_periph_M05_AXI_BRESP),
        .s_axi_bvalid(microblaze_0_axi_periph_M05_AXI_BVALID),
        .s_axi_rdata(microblaze_0_axi_periph_M05_AXI_RDATA),
        .s_axi_rready(microblaze_0_axi_periph_M05_AXI_RREADY),
        .s_axi_rresp(microblaze_0_axi_periph_M05_AXI_RRESP),
        .s_axi_rvalid(microblaze_0_axi_periph_M05_AXI_RVALID),
        .s_axi_wdata(microblaze_0_axi_periph_M05_AXI_WDATA),
        .s_axi_wready(microblaze_0_axi_periph_M05_AXI_WREADY),
        .s_axi_wstrb(microblaze_0_axi_periph_M05_AXI_WSTRB),
        .s_axi_wvalid(microblaze_0_axi_periph_M05_AXI_WVALID));
  embsys_axi_gpio_0_1 axi_gpio_1
       (.gpio2_io_i(axi_gpio_1_GPIO2_TRI_I),
        .gpio_io_i(axi_gpio_1_GPIO_TRI_I),
        .s_axi_aclk(microblaze_0_Clk),
        .s_axi_araddr(microblaze_0_axi_periph_M08_AXI_ARADDR[8:0]),
        .s_axi_aresetn(rst_clk_wiz_1_100M_peripheral_aresetn),
        .s_axi_arready(microblaze_0_axi_periph_M08_AXI_ARREADY),
        .s_axi_arvalid(microblaze_0_axi_periph_M08_AXI_ARVALID),
        .s_axi_awaddr(microblaze_0_axi_periph_M08_AXI_AWADDR[8:0]),
        .s_axi_awready(microblaze_0_axi_periph_M08_AXI_AWREADY),
        .s_axi_awvalid(microblaze_0_axi_periph_M08_AXI_AWVALID),
        .s_axi_bready(microblaze_0_axi_periph_M08_AXI_BREADY),
        .s_axi_bresp(microblaze_0_axi_periph_M08_AXI_BRESP),
        .s_axi_bvalid(microblaze_0_axi_periph_M08_AXI_BVALID),
        .s_axi_rdata(microblaze_0_axi_periph_M08_AXI_RDATA),
        .s_axi_rready(microblaze_0_axi_periph_M08_AXI_RREADY),
        .s_axi_rresp(microblaze_0_axi_periph_M08_AXI_RRESP),
        .s_axi_rvalid(microblaze_0_axi_periph_M08_AXI_RVALID),
        .s_axi_wdata(microblaze_0_axi_periph_M08_AXI_WDATA),
        .s_axi_wready(microblaze_0_axi_periph_M08_AXI_WREADY),
        .s_axi_wstrb(microblaze_0_axi_periph_M08_AXI_WSTRB),
        .s_axi_wvalid(microblaze_0_axi_periph_M08_AXI_WVALID));
  embsys_axi_iic_0_0 axi_iic_0
       (.iic2intc_irpt(axi_iic_0_iic2intc_irpt),
        .s_axi_aclk(microblaze_0_Clk),
        .s_axi_araddr(microblaze_0_axi_periph_M04_AXI_ARADDR[8:0]),
        .s_axi_aresetn(rst_clk_wiz_1_100M_peripheral_aresetn),
        .s_axi_arready(microblaze_0_axi_periph_M04_AXI_ARREADY),
        .s_axi_arvalid(microblaze_0_axi_periph_M04_AXI_ARVALID),
        .s_axi_awaddr(microblaze_0_axi_periph_M04_AXI_AWADDR[8:0]),
        .s_axi_awready(microblaze_0_axi_periph_M04_AXI_AWREADY),
        .s_axi_awvalid(microblaze_0_axi_periph_M04_AXI_AWVALID),
        .s_axi_bready(microblaze_0_axi_periph_M04_AXI_BREADY),
        .s_axi_bresp(microblaze_0_axi_periph_M04_AXI_BRESP),
        .s_axi_bvalid(microblaze_0_axi_periph_M04_AXI_BVALID),
        .s_axi_rdata(microblaze_0_axi_periph_M04_AXI_RDATA),
        .s_axi_rready(microblaze_0_axi_periph_M04_AXI_RREADY),
        .s_axi_rresp(microblaze_0_axi_periph_M04_AXI_RRESP),
        .s_axi_rvalid(microblaze_0_axi_periph_M04_AXI_RVALID),
        .s_axi_wdata(microblaze_0_axi_periph_M04_AXI_WDATA),
        .s_axi_wready(microblaze_0_axi_periph_M04_AXI_WREADY),
        .s_axi_wstrb(microblaze_0_axi_periph_M04_AXI_WSTRB),
        .s_axi_wvalid(microblaze_0_axi_periph_M04_AXI_WVALID),
        .scl_i(scl_i_1),
        .scl_o(axi_iic_0_scl_o),
        .scl_t(axi_iic_0_scl_t),
        .sda_i(sda_i_1),
        .sda_o(axi_iic_0_sda_o),
        .sda_t(axi_iic_0_sda_t));
  embsys_axi_uartlite_0_0 axi_uartlite_0
       (.rx(uart_rtl_rxd_1),
        .s_axi_aclk(microblaze_0_Clk),
        .s_axi_araddr(microblaze_0_axi_periph_M07_AXI_ARADDR[3:0]),
        .s_axi_aresetn(rst_clk_wiz_1_100M_peripheral_aresetn),
        .s_axi_arready(microblaze_0_axi_periph_M07_AXI_ARREADY),
        .s_axi_arvalid(microblaze_0_axi_periph_M07_AXI_ARVALID),
        .s_axi_awaddr(microblaze_0_axi_periph_M07_AXI_AWADDR[3:0]),
        .s_axi_awready(microblaze_0_axi_periph_M07_AXI_AWREADY),
        .s_axi_awvalid(microblaze_0_axi_periph_M07_AXI_AWVALID),
        .s_axi_bready(microblaze_0_axi_periph_M07_AXI_BREADY),
        .s_axi_bresp(microblaze_0_axi_periph_M07_AXI_BRESP),
        .s_axi_bvalid(microblaze_0_axi_periph_M07_AXI_BVALID),
        .s_axi_rdata(microblaze_0_axi_periph_M07_AXI_RDATA),
        .s_axi_rready(microblaze_0_axi_periph_M07_AXI_RREADY),
        .s_axi_rresp(microblaze_0_axi_periph_M07_AXI_RRESP),
        .s_axi_rvalid(microblaze_0_axi_periph_M07_AXI_RVALID),
        .s_axi_wdata(microblaze_0_axi_periph_M07_AXI_WDATA),
        .s_axi_wready(microblaze_0_axi_periph_M07_AXI_WREADY),
        .s_axi_wstrb(microblaze_0_axi_periph_M07_AXI_WSTRB),
        .s_axi_wvalid(microblaze_0_axi_periph_M07_AXI_WVALID),
        .tx(axi_uartlite_0_tx));
  embsys_clk_wiz_1_0 clk_wiz_1
       (.clk_in1(clk_in1_1),
        .clk_out1(microblaze_0_Clk),
        .clk_out2(clk_wiz_1_clk_out2),
        .locked(clk_wiz_1_locked));
  embsys_fit_timer_1_0 fit_timer_1
       (.Clk(microblaze_0_Clk),
        .Interrupt(fit_timer_1_Interrupt),
        .Rst(rst_clk_wiz_1_100M_peripheral_reset));
  embsys_fit_timer_2_0 fit_timer_2
       (.Clk(microblaze_0_Clk),
        .Interrupt(fit_timer_2_Interrupt),
        .Rst(rst_clk_wiz_1_100M_peripheral_reset));
  embsys_mdm_1_0 mdm_1
       (.Dbg_Capture_0(microblaze_0_debug_CAPTURE),
        .Dbg_Clk_0(microblaze_0_debug_CLK),
        .Dbg_Reg_En_0(microblaze_0_debug_REG_EN),
        .Dbg_Rst_0(microblaze_0_debug_RST),
        .Dbg_Shift_0(microblaze_0_debug_SHIFT),
        .Dbg_TDI_0(microblaze_0_debug_TDI),
        .Dbg_TDO_0(microblaze_0_debug_TDO),
        .Dbg_Update_0(microblaze_0_debug_UPDATE),
        .Debug_SYS_Rst(mdm_1_debug_sys_rst));
  (* BMM_INFO_PROCESSOR = "microblaze-le > embsys microblaze_0_local_memory/dlmb_bram_if_cntlr" *) 
  (* KEEP_HIERARCHY = "yes" *) 
  embsys_microblaze_0_0 microblaze_0
       (.Byte_Enable(microblaze_0_dlmb_1_BE),
        .Clk(microblaze_0_Clk),
        .DCE(microblaze_0_dlmb_1_CE),
        .DReady(microblaze_0_dlmb_1_READY),
        .DUE(microblaze_0_dlmb_1_UE),
        .DWait(microblaze_0_dlmb_1_WAIT),
        .D_AS(microblaze_0_dlmb_1_ADDRSTROBE),
        .Data_Addr(microblaze_0_dlmb_1_ABUS),
        .Data_Read(microblaze_0_dlmb_1_READDBUS),
        .Data_Write(microblaze_0_dlmb_1_WRITEDBUS),
        .Dbg_Capture(microblaze_0_debug_CAPTURE),
        .Dbg_Clk(microblaze_0_debug_CLK),
        .Dbg_Reg_En(microblaze_0_debug_REG_EN),
        .Dbg_Shift(microblaze_0_debug_SHIFT),
        .Dbg_TDI(microblaze_0_debug_TDI),
        .Dbg_TDO(microblaze_0_debug_TDO),
        .Dbg_Update(microblaze_0_debug_UPDATE),
        .Debug_Rst(microblaze_0_debug_RST),
        .ICE(microblaze_0_ilmb_1_CE),
        .IFetch(microblaze_0_ilmb_1_READSTROBE),
        .IReady(microblaze_0_ilmb_1_READY),
        .IUE(microblaze_0_ilmb_1_UE),
        .IWAIT(microblaze_0_ilmb_1_WAIT),
        .I_AS(microblaze_0_ilmb_1_ADDRSTROBE),
        .Instr(microblaze_0_ilmb_1_READDBUS),
        .Instr_Addr(microblaze_0_ilmb_1_ABUS),
        .Interrupt(microblaze_0_interrupt_INTERRUPT),
        .Interrupt_Ack(microblaze_0_interrupt_ACK),
        .Interrupt_Address({microblaze_0_interrupt_ADDRESS[31],microblaze_0_interrupt_ADDRESS[30],microblaze_0_interrupt_ADDRESS[29],microblaze_0_interrupt_ADDRESS[28],microblaze_0_interrupt_ADDRESS[27],microblaze_0_interrupt_ADDRESS[26],microblaze_0_interrupt_ADDRESS[25],microblaze_0_interrupt_ADDRESS[24],microblaze_0_interrupt_ADDRESS[23],microblaze_0_interrupt_ADDRESS[22],microblaze_0_interrupt_ADDRESS[21],microblaze_0_interrupt_ADDRESS[20],microblaze_0_interrupt_ADDRESS[19],microblaze_0_interrupt_ADDRESS[18],microblaze_0_interrupt_ADDRESS[17],microblaze_0_interrupt_ADDRESS[16],microblaze_0_interrupt_ADDRESS[15],microblaze_0_interrupt_ADDRESS[14],microblaze_0_interrupt_ADDRESS[13],microblaze_0_interrupt_ADDRESS[12],microblaze_0_interrupt_ADDRESS[11],microblaze_0_interrupt_ADDRESS[10],microblaze_0_interrupt_ADDRESS[9],microblaze_0_interrupt_ADDRESS[8],microblaze_0_interrupt_ADDRESS[7],microblaze_0_interrupt_ADDRESS[6],microblaze_0_interrupt_ADDRESS[5],microblaze_0_interrupt_ADDRESS[4],microblaze_0_interrupt_ADDRESS[3],microblaze_0_interrupt_ADDRESS[2],microblaze_0_interrupt_ADDRESS[1],microblaze_0_interrupt_ADDRESS[0]}),
        .M_AXI_DP_ARADDR(microblaze_0_axi_dp_ARADDR),
        .M_AXI_DP_ARPROT(microblaze_0_axi_dp_ARPROT),
        .M_AXI_DP_ARREADY(microblaze_0_axi_dp_ARREADY),
        .M_AXI_DP_ARVALID(microblaze_0_axi_dp_ARVALID),
        .M_AXI_DP_AWADDR(microblaze_0_axi_dp_AWADDR),
        .M_AXI_DP_AWPROT(microblaze_0_axi_dp_AWPROT),
        .M_AXI_DP_AWREADY(microblaze_0_axi_dp_AWREADY),
        .M_AXI_DP_AWVALID(microblaze_0_axi_dp_AWVALID),
        .M_AXI_DP_BREADY(microblaze_0_axi_dp_BREADY),
        .M_AXI_DP_BRESP(microblaze_0_axi_dp_BRESP),
        .M_AXI_DP_BVALID(microblaze_0_axi_dp_BVALID),
        .M_AXI_DP_RDATA(microblaze_0_axi_dp_RDATA),
        .M_AXI_DP_RREADY(microblaze_0_axi_dp_RREADY),
        .M_AXI_DP_RRESP(microblaze_0_axi_dp_RRESP),
        .M_AXI_DP_RVALID(microblaze_0_axi_dp_RVALID),
        .M_AXI_DP_WDATA(microblaze_0_axi_dp_WDATA),
        .M_AXI_DP_WREADY(microblaze_0_axi_dp_WREADY),
        .M_AXI_DP_WSTRB(microblaze_0_axi_dp_WSTRB),
        .M_AXI_DP_WVALID(microblaze_0_axi_dp_WVALID),
        .Read_Strobe(microblaze_0_dlmb_1_READSTROBE),
        .Reset(rst_clk_wiz_1_100M_mb_reset),
        .Write_Strobe(microblaze_0_dlmb_1_WRITESTROBE));
  embsys_microblaze_0_axi_intc_0 microblaze_0_axi_intc
       (.interrupt_address(microblaze_0_interrupt_ADDRESS),
        .intr(microblaze_0_intr),
        .irq(microblaze_0_interrupt_INTERRUPT),
        .processor_ack({microblaze_0_interrupt_ACK[0],microblaze_0_interrupt_ACK[1]}),
        .processor_clk(microblaze_0_Clk),
        .processor_rst(rst_clk_wiz_1_100M_mb_reset),
        .s_axi_aclk(microblaze_0_Clk),
        .s_axi_araddr(microblaze_0_intc_axi_ARADDR[8:0]),
        .s_axi_aresetn(rst_clk_wiz_1_100M_peripheral_aresetn),
        .s_axi_arready(microblaze_0_intc_axi_ARREADY),
        .s_axi_arvalid(microblaze_0_intc_axi_ARVALID),
        .s_axi_awaddr(microblaze_0_intc_axi_AWADDR[8:0]),
        .s_axi_awready(microblaze_0_intc_axi_AWREADY),
        .s_axi_awvalid(microblaze_0_intc_axi_AWVALID),
        .s_axi_bready(microblaze_0_intc_axi_BREADY),
        .s_axi_bresp(microblaze_0_intc_axi_BRESP),
        .s_axi_bvalid(microblaze_0_intc_axi_BVALID),
        .s_axi_rdata(microblaze_0_intc_axi_RDATA),
        .s_axi_rready(microblaze_0_intc_axi_RREADY),
        .s_axi_rresp(microblaze_0_intc_axi_RRESP),
        .s_axi_rvalid(microblaze_0_intc_axi_RVALID),
        .s_axi_wdata(microblaze_0_intc_axi_WDATA),
        .s_axi_wready(microblaze_0_intc_axi_WREADY),
        .s_axi_wstrb(microblaze_0_intc_axi_WSTRB),
        .s_axi_wvalid(microblaze_0_intc_axi_WVALID));
  embsys_microblaze_0_axi_periph_0 microblaze_0_axi_periph
       (.ACLK(microblaze_0_Clk),
        .ARESETN(rst_clk_wiz_1_100M_interconnect_aresetn),
        .M00_ACLK(microblaze_0_Clk),
        .M00_ARESETN(rst_clk_wiz_1_100M_peripheral_aresetn),
        .M00_AXI_araddr(microblaze_0_intc_axi_ARADDR),
        .M00_AXI_arready(microblaze_0_intc_axi_ARREADY),
        .M00_AXI_arvalid(microblaze_0_intc_axi_ARVALID),
        .M00_AXI_awaddr(microblaze_0_intc_axi_AWADDR),
        .M00_AXI_awready(microblaze_0_intc_axi_AWREADY),
        .M00_AXI_awvalid(microblaze_0_intc_axi_AWVALID),
        .M00_AXI_bready(microblaze_0_intc_axi_BREADY),
        .M00_AXI_bresp(microblaze_0_intc_axi_BRESP),
        .M00_AXI_bvalid(microblaze_0_intc_axi_BVALID),
        .M00_AXI_rdata(microblaze_0_intc_axi_RDATA),
        .M00_AXI_rready(microblaze_0_intc_axi_RREADY),
        .M00_AXI_rresp(microblaze_0_intc_axi_RRESP),
        .M00_AXI_rvalid(microblaze_0_intc_axi_RVALID),
        .M00_AXI_wdata(microblaze_0_intc_axi_WDATA),
        .M00_AXI_wready(microblaze_0_intc_axi_WREADY),
        .M00_AXI_wstrb(microblaze_0_intc_axi_WSTRB),
        .M00_AXI_wvalid(microblaze_0_intc_axi_WVALID),
        .M01_ACLK(microblaze_0_Clk),
        .M01_ARESETN(rst_clk_wiz_1_100M_peripheral_aresetn),
        .M01_AXI_araddr(microblaze_0_axi_periph_M01_AXI_ARADDR),
        .M01_AXI_arprot(microblaze_0_axi_periph_M01_AXI_ARPROT),
        .M01_AXI_arready(microblaze_0_axi_periph_M01_AXI_ARREADY),
        .M01_AXI_arvalid(microblaze_0_axi_periph_M01_AXI_ARVALID),
        .M01_AXI_awaddr(microblaze_0_axi_periph_M01_AXI_AWADDR),
        .M01_AXI_awprot(microblaze_0_axi_periph_M01_AXI_AWPROT),
        .M01_AXI_awready(microblaze_0_axi_periph_M01_AXI_AWREADY),
        .M01_AXI_awvalid(microblaze_0_axi_periph_M01_AXI_AWVALID),
        .M01_AXI_bready(microblaze_0_axi_periph_M01_AXI_BREADY),
        .M01_AXI_bresp(microblaze_0_axi_periph_M01_AXI_BRESP),
        .M01_AXI_bvalid(microblaze_0_axi_periph_M01_AXI_BVALID),
        .M01_AXI_rdata(microblaze_0_axi_periph_M01_AXI_RDATA),
        .M01_AXI_rready(microblaze_0_axi_periph_M01_AXI_RREADY),
        .M01_AXI_rresp(microblaze_0_axi_periph_M01_AXI_RRESP),
        .M01_AXI_rvalid(microblaze_0_axi_periph_M01_AXI_RVALID),
        .M01_AXI_wdata(microblaze_0_axi_periph_M01_AXI_WDATA),
        .M01_AXI_wready(microblaze_0_axi_periph_M01_AXI_WREADY),
        .M01_AXI_wstrb(microblaze_0_axi_periph_M01_AXI_WSTRB),
        .M01_AXI_wvalid(microblaze_0_axi_periph_M01_AXI_WVALID),
        .M02_ACLK(microblaze_0_Clk),
        .M02_ARESETN(rst_clk_wiz_1_100M_peripheral_aresetn),
        .M02_AXI_araddr(microblaze_0_axi_periph_M02_AXI_ARADDR),
        .M02_AXI_arprot(microblaze_0_axi_periph_M02_AXI_ARPROT),
        .M02_AXI_arready(microblaze_0_axi_periph_M02_AXI_ARREADY),
        .M02_AXI_arvalid(microblaze_0_axi_periph_M02_AXI_ARVALID),
        .M02_AXI_awaddr(microblaze_0_axi_periph_M02_AXI_AWADDR),
        .M02_AXI_awprot(microblaze_0_axi_periph_M02_AXI_AWPROT),
        .M02_AXI_awready(microblaze_0_axi_periph_M02_AXI_AWREADY),
        .M02_AXI_awvalid(microblaze_0_axi_periph_M02_AXI_AWVALID),
        .M02_AXI_bready(microblaze_0_axi_periph_M02_AXI_BREADY),
        .M02_AXI_bresp(microblaze_0_axi_periph_M02_AXI_BRESP),
        .M02_AXI_bvalid(microblaze_0_axi_periph_M02_AXI_BVALID),
        .M02_AXI_rdata(microblaze_0_axi_periph_M02_AXI_RDATA),
        .M02_AXI_rready(microblaze_0_axi_periph_M02_AXI_RREADY),
        .M02_AXI_rresp(microblaze_0_axi_periph_M02_AXI_RRESP),
        .M02_AXI_rvalid(microblaze_0_axi_periph_M02_AXI_RVALID),
        .M02_AXI_wdata(microblaze_0_axi_periph_M02_AXI_WDATA),
        .M02_AXI_wready(microblaze_0_axi_periph_M02_AXI_WREADY),
        .M02_AXI_wstrb(microblaze_0_axi_periph_M02_AXI_WSTRB),
        .M02_AXI_wvalid(microblaze_0_axi_periph_M02_AXI_WVALID),
        .M03_ACLK(microblaze_0_Clk),
        .M03_ARESETN(rst_clk_wiz_1_100M_peripheral_aresetn),
        .M03_AXI_araddr(microblaze_0_axi_periph_M03_AXI_ARADDR),
        .M03_AXI_arprot(microblaze_0_axi_periph_M03_AXI_ARPROT),
        .M03_AXI_arready(microblaze_0_axi_periph_M03_AXI_ARREADY),
        .M03_AXI_arvalid(microblaze_0_axi_periph_M03_AXI_ARVALID),
        .M03_AXI_awaddr(microblaze_0_axi_periph_M03_AXI_AWADDR),
        .M03_AXI_awprot(microblaze_0_axi_periph_M03_AXI_AWPROT),
        .M03_AXI_awready(microblaze_0_axi_periph_M03_AXI_AWREADY),
        .M03_AXI_awvalid(microblaze_0_axi_periph_M03_AXI_AWVALID),
        .M03_AXI_bready(microblaze_0_axi_periph_M03_AXI_BREADY),
        .M03_AXI_bresp(microblaze_0_axi_periph_M03_AXI_BRESP),
        .M03_AXI_bvalid(microblaze_0_axi_periph_M03_AXI_BVALID),
        .M03_AXI_rdata(microblaze_0_axi_periph_M03_AXI_RDATA),
        .M03_AXI_rready(microblaze_0_axi_periph_M03_AXI_RREADY),
        .M03_AXI_rresp(microblaze_0_axi_periph_M03_AXI_RRESP),
        .M03_AXI_rvalid(microblaze_0_axi_periph_M03_AXI_RVALID),
        .M03_AXI_wdata(microblaze_0_axi_periph_M03_AXI_WDATA),
        .M03_AXI_wready(microblaze_0_axi_periph_M03_AXI_WREADY),
        .M03_AXI_wstrb(microblaze_0_axi_periph_M03_AXI_WSTRB),
        .M03_AXI_wvalid(microblaze_0_axi_periph_M03_AXI_WVALID),
        .M04_ACLK(microblaze_0_Clk),
        .M04_ARESETN(rst_clk_wiz_1_100M_peripheral_aresetn),
        .M04_AXI_araddr(microblaze_0_axi_periph_M04_AXI_ARADDR),
        .M04_AXI_arready(microblaze_0_axi_periph_M04_AXI_ARREADY),
        .M04_AXI_arvalid(microblaze_0_axi_periph_M04_AXI_ARVALID),
        .M04_AXI_awaddr(microblaze_0_axi_periph_M04_AXI_AWADDR),
        .M04_AXI_awready(microblaze_0_axi_periph_M04_AXI_AWREADY),
        .M04_AXI_awvalid(microblaze_0_axi_periph_M04_AXI_AWVALID),
        .M04_AXI_bready(microblaze_0_axi_periph_M04_AXI_BREADY),
        .M04_AXI_bresp(microblaze_0_axi_periph_M04_AXI_BRESP),
        .M04_AXI_bvalid(microblaze_0_axi_periph_M04_AXI_BVALID),
        .M04_AXI_rdata(microblaze_0_axi_periph_M04_AXI_RDATA),
        .M04_AXI_rready(microblaze_0_axi_periph_M04_AXI_RREADY),
        .M04_AXI_rresp(microblaze_0_axi_periph_M04_AXI_RRESP),
        .M04_AXI_rvalid(microblaze_0_axi_periph_M04_AXI_RVALID),
        .M04_AXI_wdata(microblaze_0_axi_periph_M04_AXI_WDATA),
        .M04_AXI_wready(microblaze_0_axi_periph_M04_AXI_WREADY),
        .M04_AXI_wstrb(microblaze_0_axi_periph_M04_AXI_WSTRB),
        .M04_AXI_wvalid(microblaze_0_axi_periph_M04_AXI_WVALID),
        .M05_ACLK(microblaze_0_Clk),
        .M05_ARESETN(rst_clk_wiz_1_100M_peripheral_aresetn),
        .M05_AXI_araddr(microblaze_0_axi_periph_M05_AXI_ARADDR),
        .M05_AXI_arready(microblaze_0_axi_periph_M05_AXI_ARREADY),
        .M05_AXI_arvalid(microblaze_0_axi_periph_M05_AXI_ARVALID),
        .M05_AXI_awaddr(microblaze_0_axi_periph_M05_AXI_AWADDR),
        .M05_AXI_awready(microblaze_0_axi_periph_M05_AXI_AWREADY),
        .M05_AXI_awvalid(microblaze_0_axi_periph_M05_AXI_AWVALID),
        .M05_AXI_bready(microblaze_0_axi_periph_M05_AXI_BREADY),
        .M05_AXI_bresp(microblaze_0_axi_periph_M05_AXI_BRESP),
        .M05_AXI_bvalid(microblaze_0_axi_periph_M05_AXI_BVALID),
        .M05_AXI_rdata(microblaze_0_axi_periph_M05_AXI_RDATA),
        .M05_AXI_rready(microblaze_0_axi_periph_M05_AXI_RREADY),
        .M05_AXI_rresp(microblaze_0_axi_periph_M05_AXI_RRESP),
        .M05_AXI_rvalid(microblaze_0_axi_periph_M05_AXI_RVALID),
        .M05_AXI_wdata(microblaze_0_axi_periph_M05_AXI_WDATA),
        .M05_AXI_wready(microblaze_0_axi_periph_M05_AXI_WREADY),
        .M05_AXI_wstrb(microblaze_0_axi_periph_M05_AXI_WSTRB),
        .M05_AXI_wvalid(microblaze_0_axi_periph_M05_AXI_WVALID),
        .M06_ACLK(microblaze_0_Clk),
        .M06_ARESETN(rst_clk_wiz_1_100M_peripheral_aresetn),
        .M06_AXI_arready(1'b0),
        .M06_AXI_awready(1'b0),
        .M06_AXI_bresp({1'b0,1'b0}),
        .M06_AXI_bvalid(1'b0),
        .M06_AXI_rdata({1'b0,1'b0,1'b0,1'b0,1'b0,1'b0,1'b0,1'b0,1'b0,1'b0,1'b0,1'b0,1'b0,1'b0,1'b0,1'b0,1'b0,1'b0,1'b0,1'b0,1'b0,1'b0,1'b0,1'b0,1'b0,1'b0,1'b0,1'b0,1'b0,1'b0,1'b0,1'b0}),
        .M06_AXI_rresp({1'b0,1'b0}),
        .M06_AXI_rvalid(1'b0),
        .M06_AXI_wready(1'b0),
        .M07_ACLK(microblaze_0_Clk),
        .M07_ARESETN(rst_clk_wiz_1_100M_peripheral_aresetn),
        .M07_AXI_araddr(microblaze_0_axi_periph_M07_AXI_ARADDR),
        .M07_AXI_arready(microblaze_0_axi_periph_M07_AXI_ARREADY),
        .M07_AXI_arvalid(microblaze_0_axi_periph_M07_AXI_ARVALID),
        .M07_AXI_awaddr(microblaze_0_axi_periph_M07_AXI_AWADDR),
        .M07_AXI_awready(microblaze_0_axi_periph_M07_AXI_AWREADY),
        .M07_AXI_awvalid(microblaze_0_axi_periph_M07_AXI_AWVALID),
        .M07_AXI_bready(microblaze_0_axi_periph_M07_AXI_BREADY),
        .M07_AXI_bresp(microblaze_0_axi_periph_M07_AXI_BRESP),
        .M07_AXI_bvalid(microblaze_0_axi_periph_M07_AXI_BVALID),
        .M07_AXI_rdata(microblaze_0_axi_periph_M07_AXI_RDATA),
        .M07_AXI_rready(microblaze_0_axi_periph_M07_AXI_RREADY),
        .M07_AXI_rresp(microblaze_0_axi_periph_M07_AXI_RRESP),
        .M07_AXI_rvalid(microblaze_0_axi_periph_M07_AXI_RVALID),
        .M07_AXI_wdata(microblaze_0_axi_periph_M07_AXI_WDATA),
        .M07_AXI_wready(microblaze_0_axi_periph_M07_AXI_WREADY),
        .M07_AXI_wstrb(microblaze_0_axi_periph_M07_AXI_WSTRB),
        .M07_AXI_wvalid(microblaze_0_axi_periph_M07_AXI_WVALID),
        .M08_ACLK(microblaze_0_Clk),
        .M08_ARESETN(rst_clk_wiz_1_100M_peripheral_aresetn),
        .M08_AXI_araddr(microblaze_0_axi_periph_M08_AXI_ARADDR),
        .M08_AXI_arready(microblaze_0_axi_periph_M08_AXI_ARREADY),
        .M08_AXI_arvalid(microblaze_0_axi_periph_M08_AXI_ARVALID),
        .M08_AXI_awaddr(microblaze_0_axi_periph_M08_AXI_AWADDR),
        .M08_AXI_awready(microblaze_0_axi_periph_M08_AXI_AWREADY),
        .M08_AXI_awvalid(microblaze_0_axi_periph_M08_AXI_AWVALID),
        .M08_AXI_bready(microblaze_0_axi_periph_M08_AXI_BREADY),
        .M08_AXI_bresp(microblaze_0_axi_periph_M08_AXI_BRESP),
        .M08_AXI_bvalid(microblaze_0_axi_periph_M08_AXI_BVALID),
        .M08_AXI_rdata(microblaze_0_axi_periph_M08_AXI_RDATA),
        .M08_AXI_rready(microblaze_0_axi_periph_M08_AXI_RREADY),
        .M08_AXI_rresp(microblaze_0_axi_periph_M08_AXI_RRESP),
        .M08_AXI_rvalid(microblaze_0_axi_periph_M08_AXI_RVALID),
        .M08_AXI_wdata(microblaze_0_axi_periph_M08_AXI_WDATA),
        .M08_AXI_wready(microblaze_0_axi_periph_M08_AXI_WREADY),
        .M08_AXI_wstrb(microblaze_0_axi_periph_M08_AXI_WSTRB),
        .M08_AXI_wvalid(microblaze_0_axi_periph_M08_AXI_WVALID),
        .M09_ACLK(microblaze_0_Clk),
        .M09_ARESETN(rst_clk_wiz_1_100M_peripheral_aresetn),
        .M09_AXI_araddr(microblaze_0_axi_periph_M09_AXI_ARADDR),
        .M09_AXI_arready(microblaze_0_axi_periph_M09_AXI_ARREADY),
        .M09_AXI_arvalid(microblaze_0_axi_periph_M09_AXI_ARVALID),
        .M09_AXI_awaddr(microblaze_0_axi_periph_M09_AXI_AWADDR),
        .M09_AXI_awready(microblaze_0_axi_periph_M09_AXI_AWREADY),
        .M09_AXI_awvalid(microblaze_0_axi_periph_M09_AXI_AWVALID),
        .M09_AXI_bready(microblaze_0_axi_periph_M09_AXI_BREADY),
        .M09_AXI_bresp(microblaze_0_axi_periph_M09_AXI_BRESP),
        .M09_AXI_bvalid(microblaze_0_axi_periph_M09_AXI_BVALID),
        .M09_AXI_rdata(microblaze_0_axi_periph_M09_AXI_RDATA),
        .M09_AXI_rready(microblaze_0_axi_periph_M09_AXI_RREADY),
        .M09_AXI_rresp(microblaze_0_axi_periph_M09_AXI_RRESP),
        .M09_AXI_rvalid(microblaze_0_axi_periph_M09_AXI_RVALID),
        .M09_AXI_wdata(microblaze_0_axi_periph_M09_AXI_WDATA),
        .M09_AXI_wready(microblaze_0_axi_periph_M09_AXI_WREADY),
        .M09_AXI_wstrb(microblaze_0_axi_periph_M09_AXI_WSTRB),
        .M09_AXI_wvalid(microblaze_0_axi_periph_M09_AXI_WVALID),
        .M10_ACLK(microblaze_0_Clk),
        .M10_ARESETN(rst_clk_wiz_1_100M_peripheral_aresetn),
        .M10_AXI_araddr(microblaze_0_axi_periph_M10_AXI_ARADDR),
        .M10_AXI_arready(microblaze_0_axi_periph_M10_AXI_ARREADY),
        .M10_AXI_arvalid(microblaze_0_axi_periph_M10_AXI_ARVALID),
        .M10_AXI_awaddr(microblaze_0_axi_periph_M10_AXI_AWADDR),
        .M10_AXI_awready(microblaze_0_axi_periph_M10_AXI_AWREADY),
        .M10_AXI_awvalid(microblaze_0_axi_periph_M10_AXI_AWVALID),
        .M10_AXI_bready(microblaze_0_axi_periph_M10_AXI_BREADY),
        .M10_AXI_bresp(microblaze_0_axi_periph_M10_AXI_BRESP),
        .M10_AXI_bvalid(microblaze_0_axi_periph_M10_AXI_BVALID),
        .M10_AXI_rdata(microblaze_0_axi_periph_M10_AXI_RDATA),
        .M10_AXI_rready(microblaze_0_axi_periph_M10_AXI_RREADY),
        .M10_AXI_rresp(microblaze_0_axi_periph_M10_AXI_RRESP),
        .M10_AXI_rvalid(microblaze_0_axi_periph_M10_AXI_RVALID),
        .M10_AXI_wdata(microblaze_0_axi_periph_M10_AXI_WDATA),
        .M10_AXI_wready(microblaze_0_axi_periph_M10_AXI_WREADY),
        .M10_AXI_wstrb(microblaze_0_axi_periph_M10_AXI_WSTRB),
        .M10_AXI_wvalid(microblaze_0_axi_periph_M10_AXI_WVALID),
        .M11_ACLK(microblaze_0_Clk),
        .M11_ARESETN(rst_clk_wiz_1_100M_peripheral_aresetn),
        .M11_AXI_arready(1'b0),
        .M11_AXI_awready(1'b0),
        .M11_AXI_bresp(1'b0),
        .M11_AXI_bvalid(1'b0),
        .M11_AXI_rdata(1'b0),
        .M11_AXI_rresp(1'b0),
        .M11_AXI_rvalid(1'b0),
        .M11_AXI_wready(1'b0),
        .S00_ACLK(microblaze_0_Clk),
        .S00_ARESETN(rst_clk_wiz_1_100M_peripheral_aresetn),
        .S00_AXI_araddr(microblaze_0_axi_dp_ARADDR),
        .S00_AXI_arprot(microblaze_0_axi_dp_ARPROT),
        .S00_AXI_arready(microblaze_0_axi_dp_ARREADY),
        .S00_AXI_arvalid(microblaze_0_axi_dp_ARVALID),
        .S00_AXI_awaddr(microblaze_0_axi_dp_AWADDR),
        .S00_AXI_awprot(microblaze_0_axi_dp_AWPROT),
        .S00_AXI_awready(microblaze_0_axi_dp_AWREADY),
        .S00_AXI_awvalid(microblaze_0_axi_dp_AWVALID),
        .S00_AXI_bready(microblaze_0_axi_dp_BREADY),
        .S00_AXI_bresp(microblaze_0_axi_dp_BRESP),
        .S00_AXI_bvalid(microblaze_0_axi_dp_BVALID),
        .S00_AXI_rdata(microblaze_0_axi_dp_RDATA),
        .S00_AXI_rready(microblaze_0_axi_dp_RREADY),
        .S00_AXI_rresp(microblaze_0_axi_dp_RRESP),
        .S00_AXI_rvalid(microblaze_0_axi_dp_RVALID),
        .S00_AXI_wdata(microblaze_0_axi_dp_WDATA),
        .S00_AXI_wready(microblaze_0_axi_dp_WREADY),
        .S00_AXI_wstrb(microblaze_0_axi_dp_WSTRB),
        .S00_AXI_wvalid(microblaze_0_axi_dp_WVALID));
  microblaze_0_local_memory_imp_1SR2TDT microblaze_0_local_memory
       (.DLMB_abus(microblaze_0_dlmb_1_ABUS),
        .DLMB_addrstrobe(microblaze_0_dlmb_1_ADDRSTROBE),
        .DLMB_be(microblaze_0_dlmb_1_BE),
        .DLMB_ce(microblaze_0_dlmb_1_CE),
        .DLMB_readdbus(microblaze_0_dlmb_1_READDBUS),
        .DLMB_readstrobe(microblaze_0_dlmb_1_READSTROBE),
        .DLMB_ready(microblaze_0_dlmb_1_READY),
        .DLMB_ue(microblaze_0_dlmb_1_UE),
        .DLMB_wait(microblaze_0_dlmb_1_WAIT),
        .DLMB_writedbus(microblaze_0_dlmb_1_WRITEDBUS),
        .DLMB_writestrobe(microblaze_0_dlmb_1_WRITESTROBE),
        .ILMB_abus(microblaze_0_ilmb_1_ABUS),
        .ILMB_addrstrobe(microblaze_0_ilmb_1_ADDRSTROBE),
        .ILMB_ce(microblaze_0_ilmb_1_CE),
        .ILMB_readdbus(microblaze_0_ilmb_1_READDBUS),
        .ILMB_readstrobe(microblaze_0_ilmb_1_READSTROBE),
        .ILMB_ready(microblaze_0_ilmb_1_READY),
        .ILMB_ue(microblaze_0_ilmb_1_UE),
        .ILMB_wait(microblaze_0_ilmb_1_WAIT),
        .LMB_Clk(microblaze_0_Clk),
        .SYS_Rst(rst_clk_wiz_1_100M_bus_struct_reset));
  embsys_microblaze_0_xlconcat_0 microblaze_0_xlconcat
       (.In0(fit_timer_1_Interrupt),
        .In1(\^btnC ),
        .In2(fit_timer_2_Interrupt),
        .In3(PmodBT2_0_BT2_uart_interrupt),
        .In4(axi_iic_0_iic2intc_irpt),
        .dout(microblaze_0_intr));
  embsys_nexys4IO_0_2 nexys4IO_0
       (.Clock(microblaze_0_Clk),
        .RGB1_Blue(nexys4IO_0_RGB1_Blue),
        .RGB1_Green(nexys4IO_0_RGB1_Green),
        .RGB1_Red(nexys4IO_0_RGB1_Red),
        .RGB2_Blue(nexys4IO_0_RGB2_Blue),
        .RGB2_Green(nexys4IO_0_RGB2_Green),
        .RGB2_Red(nexys4IO_0_RGB2_Red),
        .an(nexys4IO_0_an),
        .btnC(btnC_1),
        .btnD(btnD_1),
        .btnL(btnL_1),
        .btnR(btnR_1),
        .btnU(btnU_1),
        .db_btns(nexys4IO_0_db_btns),
        .dp(nexys4IO_0_dp),
        .led(nexys4IO_0_led),
        .s00_axi_aclk(microblaze_0_Clk),
        .s00_axi_araddr(microblaze_0_axi_periph_M01_AXI_ARADDR[5:0]),
        .s00_axi_aresetn(rst_clk_wiz_1_100M_peripheral_aresetn),
        .s00_axi_arprot(microblaze_0_axi_periph_M01_AXI_ARPROT),
        .s00_axi_arready(microblaze_0_axi_periph_M01_AXI_ARREADY),
        .s00_axi_arvalid(microblaze_0_axi_periph_M01_AXI_ARVALID),
        .s00_axi_awaddr(microblaze_0_axi_periph_M01_AXI_AWADDR[5:0]),
        .s00_axi_awprot(microblaze_0_axi_periph_M01_AXI_AWPROT),
        .s00_axi_awready(microblaze_0_axi_periph_M01_AXI_AWREADY),
        .s00_axi_awvalid(microblaze_0_axi_periph_M01_AXI_AWVALID),
        .s00_axi_bready(microblaze_0_axi_periph_M01_AXI_BREADY),
        .s00_axi_bresp(microblaze_0_axi_periph_M01_AXI_BRESP),
        .s00_axi_bvalid(microblaze_0_axi_periph_M01_AXI_BVALID),
        .s00_axi_rdata(microblaze_0_axi_periph_M01_AXI_RDATA),
        .s00_axi_rready(microblaze_0_axi_periph_M01_AXI_RREADY),
        .s00_axi_rresp(microblaze_0_axi_periph_M01_AXI_RRESP),
        .s00_axi_rvalid(microblaze_0_axi_periph_M01_AXI_RVALID),
        .s00_axi_wdata(microblaze_0_axi_periph_M01_AXI_WDATA),
        .s00_axi_wready(microblaze_0_axi_periph_M01_AXI_WREADY),
        .s00_axi_wstrb(microblaze_0_axi_periph_M01_AXI_WSTRB),
        .s00_axi_wvalid(microblaze_0_axi_periph_M01_AXI_WVALID),
        .seg(nexys4IO_0_seg),
        .sw(sw_1));
  embsys_rst_clk_wiz_1_100M_0 rst_clk_wiz_1_100M
       (.aux_reset_in(1'b1),
        .bus_struct_reset(rst_clk_wiz_1_100M_bus_struct_reset),
        .dcm_locked(clk_wiz_1_locked),
        .ext_reset_in(ext_reset_in_1),
        .interconnect_aresetn(rst_clk_wiz_1_100M_interconnect_aresetn),
        .mb_debug_sys_rst(mdm_1_debug_sys_rst),
        .mb_reset(rst_clk_wiz_1_100M_mb_reset),
        .peripheral_aresetn(rst_clk_wiz_1_100M_peripheral_aresetn),
        .peripheral_reset(rst_clk_wiz_1_100M_peripheral_reset),
        .slowest_sync_clk(microblaze_0_Clk));
  embsys_xlslice_0_0 xlslice_0
       (.Din(nexys4IO_0_db_btns),
        .Dout(\^btnC ));
endmodule

module embsys_microblaze_0_axi_periph_0
   (ACLK,
    ARESETN,
    M00_ACLK,
    M00_ARESETN,
    M00_AXI_araddr,
    M00_AXI_arready,
    M00_AXI_arvalid,
    M00_AXI_awaddr,
    M00_AXI_awready,
    M00_AXI_awvalid,
    M00_AXI_bready,
    M00_AXI_bresp,
    M00_AXI_bvalid,
    M00_AXI_rdata,
    M00_AXI_rready,
    M00_AXI_rresp,
    M00_AXI_rvalid,
    M00_AXI_wdata,
    M00_AXI_wready,
    M00_AXI_wstrb,
    M00_AXI_wvalid,
    M01_ACLK,
    M01_ARESETN,
    M01_AXI_araddr,
    M01_AXI_arprot,
    M01_AXI_arready,
    M01_AXI_arvalid,
    M01_AXI_awaddr,
    M01_AXI_awprot,
    M01_AXI_awready,
    M01_AXI_awvalid,
    M01_AXI_bready,
    M01_AXI_bresp,
    M01_AXI_bvalid,
    M01_AXI_rdata,
    M01_AXI_rready,
    M01_AXI_rresp,
    M01_AXI_rvalid,
    M01_AXI_wdata,
    M01_AXI_wready,
    M01_AXI_wstrb,
    M01_AXI_wvalid,
    M02_ACLK,
    M02_ARESETN,
    M02_AXI_araddr,
    M02_AXI_arprot,
    M02_AXI_arready,
    M02_AXI_arvalid,
    M02_AXI_awaddr,
    M02_AXI_awprot,
    M02_AXI_awready,
    M02_AXI_awvalid,
    M02_AXI_bready,
    M02_AXI_bresp,
    M02_AXI_bvalid,
    M02_AXI_rdata,
    M02_AXI_rready,
    M02_AXI_rresp,
    M02_AXI_rvalid,
    M02_AXI_wdata,
    M02_AXI_wready,
    M02_AXI_wstrb,
    M02_AXI_wvalid,
    M03_ACLK,
    M03_ARESETN,
    M03_AXI_araddr,
    M03_AXI_arprot,
    M03_AXI_arready,
    M03_AXI_arvalid,
    M03_AXI_awaddr,
    M03_AXI_awprot,
    M03_AXI_awready,
    M03_AXI_awvalid,
    M03_AXI_bready,
    M03_AXI_bresp,
    M03_AXI_bvalid,
    M03_AXI_rdata,
    M03_AXI_rready,
    M03_AXI_rresp,
    M03_AXI_rvalid,
    M03_AXI_wdata,
    M03_AXI_wready,
    M03_AXI_wstrb,
    M03_AXI_wvalid,
    M04_ACLK,
    M04_ARESETN,
    M04_AXI_araddr,
    M04_AXI_arready,
    M04_AXI_arvalid,
    M04_AXI_awaddr,
    M04_AXI_awready,
    M04_AXI_awvalid,
    M04_AXI_bready,
    M04_AXI_bresp,
    M04_AXI_bvalid,
    M04_AXI_rdata,
    M04_AXI_rready,
    M04_AXI_rresp,
    M04_AXI_rvalid,
    M04_AXI_wdata,
    M04_AXI_wready,
    M04_AXI_wstrb,
    M04_AXI_wvalid,
    M05_ACLK,
    M05_ARESETN,
    M05_AXI_araddr,
    M05_AXI_arready,
    M05_AXI_arvalid,
    M05_AXI_awaddr,
    M05_AXI_awready,
    M05_AXI_awvalid,
    M05_AXI_bready,
    M05_AXI_bresp,
    M05_AXI_bvalid,
    M05_AXI_rdata,
    M05_AXI_rready,
    M05_AXI_rresp,
    M05_AXI_rvalid,
    M05_AXI_wdata,
    M05_AXI_wready,
    M05_AXI_wstrb,
    M05_AXI_wvalid,
    M06_ACLK,
    M06_ARESETN,
    M06_AXI_araddr,
    M06_AXI_arprot,
    M06_AXI_arready,
    M06_AXI_arvalid,
    M06_AXI_awaddr,
    M06_AXI_awprot,
    M06_AXI_awready,
    M06_AXI_awvalid,
    M06_AXI_bready,
    M06_AXI_bresp,
    M06_AXI_bvalid,
    M06_AXI_rdata,
    M06_AXI_rready,
    M06_AXI_rresp,
    M06_AXI_rvalid,
    M06_AXI_wdata,
    M06_AXI_wready,
    M06_AXI_wstrb,
    M06_AXI_wvalid,
    M07_ACLK,
    M07_ARESETN,
    M07_AXI_araddr,
    M07_AXI_arready,
    M07_AXI_arvalid,
    M07_AXI_awaddr,
    M07_AXI_awready,
    M07_AXI_awvalid,
    M07_AXI_bready,
    M07_AXI_bresp,
    M07_AXI_bvalid,
    M07_AXI_rdata,
    M07_AXI_rready,
    M07_AXI_rresp,
    M07_AXI_rvalid,
    M07_AXI_wdata,
    M07_AXI_wready,
    M07_AXI_wstrb,
    M07_AXI_wvalid,
    M08_ACLK,
    M08_ARESETN,
    M08_AXI_araddr,
    M08_AXI_arready,
    M08_AXI_arvalid,
    M08_AXI_awaddr,
    M08_AXI_awready,
    M08_AXI_awvalid,
    M08_AXI_bready,
    M08_AXI_bresp,
    M08_AXI_bvalid,
    M08_AXI_rdata,
    M08_AXI_rready,
    M08_AXI_rresp,
    M08_AXI_rvalid,
    M08_AXI_wdata,
    M08_AXI_wready,
    M08_AXI_wstrb,
    M08_AXI_wvalid,
    M09_ACLK,
    M09_ARESETN,
    M09_AXI_araddr,
    M09_AXI_arready,
    M09_AXI_arvalid,
    M09_AXI_awaddr,
    M09_AXI_awready,
    M09_AXI_awvalid,
    M09_AXI_bready,
    M09_AXI_bresp,
    M09_AXI_bvalid,
    M09_AXI_rdata,
    M09_AXI_rready,
    M09_AXI_rresp,
    M09_AXI_rvalid,
    M09_AXI_wdata,
    M09_AXI_wready,
    M09_AXI_wstrb,
    M09_AXI_wvalid,
    M10_ACLK,
    M10_ARESETN,
    M10_AXI_araddr,
    M10_AXI_arready,
    M10_AXI_arvalid,
    M10_AXI_awaddr,
    M10_AXI_awready,
    M10_AXI_awvalid,
    M10_AXI_bready,
    M10_AXI_bresp,
    M10_AXI_bvalid,
    M10_AXI_rdata,
    M10_AXI_rready,
    M10_AXI_rresp,
    M10_AXI_rvalid,
    M10_AXI_wdata,
    M10_AXI_wready,
    M10_AXI_wstrb,
    M10_AXI_wvalid,
    M11_ACLK,
    M11_ARESETN,
    M11_AXI_araddr,
    M11_AXI_arprot,
    M11_AXI_arready,
    M11_AXI_arvalid,
    M11_AXI_awaddr,
    M11_AXI_awprot,
    M11_AXI_awready,
    M11_AXI_awvalid,
    M11_AXI_bready,
    M11_AXI_bresp,
    M11_AXI_bvalid,
    M11_AXI_rdata,
    M11_AXI_rready,
    M11_AXI_rresp,
    M11_AXI_rvalid,
    M11_AXI_wdata,
    M11_AXI_wready,
    M11_AXI_wstrb,
    M11_AXI_wvalid,
    S00_ACLK,
    S00_ARESETN,
    S00_AXI_araddr,
    S00_AXI_arprot,
    S00_AXI_arready,
    S00_AXI_arvalid,
    S00_AXI_awaddr,
    S00_AXI_awprot,
    S00_AXI_awready,
    S00_AXI_awvalid,
    S00_AXI_bready,
    S00_AXI_bresp,
    S00_AXI_bvalid,
    S00_AXI_rdata,
    S00_AXI_rready,
    S00_AXI_rresp,
    S00_AXI_rvalid,
    S00_AXI_wdata,
    S00_AXI_wready,
    S00_AXI_wstrb,
    S00_AXI_wvalid);
  input ACLK;
  input [0:0]ARESETN;
  input M00_ACLK;
  input [0:0]M00_ARESETN;
  output [31:0]M00_AXI_araddr;
  input M00_AXI_arready;
  output M00_AXI_arvalid;
  output [31:0]M00_AXI_awaddr;
  input M00_AXI_awready;
  output M00_AXI_awvalid;
  output M00_AXI_bready;
  input [1:0]M00_AXI_bresp;
  input M00_AXI_bvalid;
  input [31:0]M00_AXI_rdata;
  output M00_AXI_rready;
  input [1:0]M00_AXI_rresp;
  input M00_AXI_rvalid;
  output [31:0]M00_AXI_wdata;
  input M00_AXI_wready;
  output [3:0]M00_AXI_wstrb;
  output M00_AXI_wvalid;
  input M01_ACLK;
  input [0:0]M01_ARESETN;
  output [31:0]M01_AXI_araddr;
  output [2:0]M01_AXI_arprot;
  input M01_AXI_arready;
  output M01_AXI_arvalid;
  output [31:0]M01_AXI_awaddr;
  output [2:0]M01_AXI_awprot;
  input M01_AXI_awready;
  output M01_AXI_awvalid;
  output M01_AXI_bready;
  input [1:0]M01_AXI_bresp;
  input M01_AXI_bvalid;
  input [31:0]M01_AXI_rdata;
  output M01_AXI_rready;
  input [1:0]M01_AXI_rresp;
  input M01_AXI_rvalid;
  output [31:0]M01_AXI_wdata;
  input M01_AXI_wready;
  output [3:0]M01_AXI_wstrb;
  output M01_AXI_wvalid;
  input M02_ACLK;
  input [0:0]M02_ARESETN;
  output [31:0]M02_AXI_araddr;
  output [2:0]M02_AXI_arprot;
  input [0:0]M02_AXI_arready;
  output [0:0]M02_AXI_arvalid;
  output [31:0]M02_AXI_awaddr;
  output [2:0]M02_AXI_awprot;
  input [0:0]M02_AXI_awready;
  output [0:0]M02_AXI_awvalid;
  output [0:0]M02_AXI_bready;
  input [1:0]M02_AXI_bresp;
  input [0:0]M02_AXI_bvalid;
  input [31:0]M02_AXI_rdata;
  output [0:0]M02_AXI_rready;
  input [1:0]M02_AXI_rresp;
  input [0:0]M02_AXI_rvalid;
  output [31:0]M02_AXI_wdata;
  input [0:0]M02_AXI_wready;
  output [3:0]M02_AXI_wstrb;
  output [0:0]M02_AXI_wvalid;
  input M03_ACLK;
  input [0:0]M03_ARESETN;
  output [31:0]M03_AXI_araddr;
  output [2:0]M03_AXI_arprot;
  input M03_AXI_arready;
  output M03_AXI_arvalid;
  output [31:0]M03_AXI_awaddr;
  output [2:0]M03_AXI_awprot;
  input M03_AXI_awready;
  output M03_AXI_awvalid;
  output M03_AXI_bready;
  input [1:0]M03_AXI_bresp;
  input M03_AXI_bvalid;
  input [31:0]M03_AXI_rdata;
  output M03_AXI_rready;
  input [1:0]M03_AXI_rresp;
  input M03_AXI_rvalid;
  output [31:0]M03_AXI_wdata;
  input M03_AXI_wready;
  output [3:0]M03_AXI_wstrb;
  output M03_AXI_wvalid;
  input M04_ACLK;
  input [0:0]M04_ARESETN;
  output [31:0]M04_AXI_araddr;
  input M04_AXI_arready;
  output M04_AXI_arvalid;
  output [31:0]M04_AXI_awaddr;
  input M04_AXI_awready;
  output M04_AXI_awvalid;
  output M04_AXI_bready;
  input [1:0]M04_AXI_bresp;
  input M04_AXI_bvalid;
  input [31:0]M04_AXI_rdata;
  output M04_AXI_rready;
  input [1:0]M04_AXI_rresp;
  input M04_AXI_rvalid;
  output [31:0]M04_AXI_wdata;
  input M04_AXI_wready;
  output [3:0]M04_AXI_wstrb;
  output M04_AXI_wvalid;
  input M05_ACLK;
  input [0:0]M05_ARESETN;
  output [31:0]M05_AXI_araddr;
  input M05_AXI_arready;
  output M05_AXI_arvalid;
  output [31:0]M05_AXI_awaddr;
  input M05_AXI_awready;
  output M05_AXI_awvalid;
  output M05_AXI_bready;
  input [1:0]M05_AXI_bresp;
  input M05_AXI_bvalid;
  input [31:0]M05_AXI_rdata;
  output M05_AXI_rready;
  input [1:0]M05_AXI_rresp;
  input M05_AXI_rvalid;
  output [31:0]M05_AXI_wdata;
  input M05_AXI_wready;
  output [3:0]M05_AXI_wstrb;
  output M05_AXI_wvalid;
  input M06_ACLK;
  input [0:0]M06_ARESETN;
  output [31:0]M06_AXI_araddr;
  output [2:0]M06_AXI_arprot;
  input M06_AXI_arready;
  output M06_AXI_arvalid;
  output [31:0]M06_AXI_awaddr;
  output [2:0]M06_AXI_awprot;
  input M06_AXI_awready;
  output M06_AXI_awvalid;
  output M06_AXI_bready;
  input [1:0]M06_AXI_bresp;
  input M06_AXI_bvalid;
  input [31:0]M06_AXI_rdata;
  output M06_AXI_rready;
  input [1:0]M06_AXI_rresp;
  input M06_AXI_rvalid;
  output [31:0]M06_AXI_wdata;
  input M06_AXI_wready;
  output [3:0]M06_AXI_wstrb;
  output M06_AXI_wvalid;
  input M07_ACLK;
  input [0:0]M07_ARESETN;
  output [31:0]M07_AXI_araddr;
  input [0:0]M07_AXI_arready;
  output [0:0]M07_AXI_arvalid;
  output [31:0]M07_AXI_awaddr;
  input [0:0]M07_AXI_awready;
  output [0:0]M07_AXI_awvalid;
  output [0:0]M07_AXI_bready;
  input [1:0]M07_AXI_bresp;
  input [0:0]M07_AXI_bvalid;
  input [31:0]M07_AXI_rdata;
  output [0:0]M07_AXI_rready;
  input [1:0]M07_AXI_rresp;
  input [0:0]M07_AXI_rvalid;
  output [31:0]M07_AXI_wdata;
  input [0:0]M07_AXI_wready;
  output [3:0]M07_AXI_wstrb;
  output [0:0]M07_AXI_wvalid;
  input M08_ACLK;
  input [0:0]M08_ARESETN;
  output [31:0]M08_AXI_araddr;
  input M08_AXI_arready;
  output M08_AXI_arvalid;
  output [31:0]M08_AXI_awaddr;
  input M08_AXI_awready;
  output M08_AXI_awvalid;
  output M08_AXI_bready;
  input [1:0]M08_AXI_bresp;
  input M08_AXI_bvalid;
  input [31:0]M08_AXI_rdata;
  output M08_AXI_rready;
  input [1:0]M08_AXI_rresp;
  input M08_AXI_rvalid;
  output [31:0]M08_AXI_wdata;
  input M08_AXI_wready;
  output [3:0]M08_AXI_wstrb;
  output M08_AXI_wvalid;
  input M09_ACLK;
  input [0:0]M09_ARESETN;
  output [31:0]M09_AXI_araddr;
  input M09_AXI_arready;
  output M09_AXI_arvalid;
  output [31:0]M09_AXI_awaddr;
  input M09_AXI_awready;
  output M09_AXI_awvalid;
  output M09_AXI_bready;
  input [1:0]M09_AXI_bresp;
  input M09_AXI_bvalid;
  input [31:0]M09_AXI_rdata;
  output M09_AXI_rready;
  input [1:0]M09_AXI_rresp;
  input M09_AXI_rvalid;
  output [31:0]M09_AXI_wdata;
  input M09_AXI_wready;
  output [3:0]M09_AXI_wstrb;
  output M09_AXI_wvalid;
  input M10_ACLK;
  input [0:0]M10_ARESETN;
  output [31:0]M10_AXI_araddr;
  input M10_AXI_arready;
  output M10_AXI_arvalid;
  output [31:0]M10_AXI_awaddr;
  input M10_AXI_awready;
  output M10_AXI_awvalid;
  output M10_AXI_bready;
  input [1:0]M10_AXI_bresp;
  input M10_AXI_bvalid;
  input [31:0]M10_AXI_rdata;
  output M10_AXI_rready;
  input [1:0]M10_AXI_rresp;
  input M10_AXI_rvalid;
  output [31:0]M10_AXI_wdata;
  input M10_AXI_wready;
  output [3:0]M10_AXI_wstrb;
  output M10_AXI_wvalid;
  input M11_ACLK;
  input [0:0]M11_ARESETN;
  output M11_AXI_araddr;
  output M11_AXI_arprot;
  input M11_AXI_arready;
  output M11_AXI_arvalid;
  output M11_AXI_awaddr;
  output M11_AXI_awprot;
  input M11_AXI_awready;
  output M11_AXI_awvalid;
  output M11_AXI_bready;
  input M11_AXI_bresp;
  input M11_AXI_bvalid;
  input M11_AXI_rdata;
  output M11_AXI_rready;
  input M11_AXI_rresp;
  input M11_AXI_rvalid;
  output M11_AXI_wdata;
  input M11_AXI_wready;
  output M11_AXI_wstrb;
  output M11_AXI_wvalid;
  input S00_ACLK;
  input [0:0]S00_ARESETN;
  input [31:0]S00_AXI_araddr;
  input [2:0]S00_AXI_arprot;
  output [0:0]S00_AXI_arready;
  input [0:0]S00_AXI_arvalid;
  input [31:0]S00_AXI_awaddr;
  input [2:0]S00_AXI_awprot;
  output [0:0]S00_AXI_awready;
  input [0:0]S00_AXI_awvalid;
  input [0:0]S00_AXI_bready;
  output [1:0]S00_AXI_bresp;
  output [0:0]S00_AXI_bvalid;
  output [31:0]S00_AXI_rdata;
  input [0:0]S00_AXI_rready;
  output [1:0]S00_AXI_rresp;
  output [0:0]S00_AXI_rvalid;
  input [31:0]S00_AXI_wdata;
  output [0:0]S00_AXI_wready;
  input [3:0]S00_AXI_wstrb;
  input [0:0]S00_AXI_wvalid;

  wire M00_ACLK_1;
  wire [0:0]M00_ARESETN_1;
  wire M01_ACLK_1;
  wire [0:0]M01_ARESETN_1;
  wire M02_ACLK_1;
  wire [0:0]M02_ARESETN_1;
  wire M03_ACLK_1;
  wire [0:0]M03_ARESETN_1;
  wire M04_ACLK_1;
  wire [0:0]M04_ARESETN_1;
  wire M05_ACLK_1;
  wire [0:0]M05_ARESETN_1;
  wire M06_ACLK_1;
  wire [0:0]M06_ARESETN_1;
  wire M07_ACLK_1;
  wire [0:0]M07_ARESETN_1;
  wire M08_ACLK_1;
  wire [0:0]M08_ARESETN_1;
  wire M09_ACLK_1;
  wire [0:0]M09_ARESETN_1;
  wire M10_ACLK_1;
  wire [0:0]M10_ARESETN_1;
  wire M11_ACLK_1;
  wire [0:0]M11_ARESETN_1;
  wire S00_ACLK_1;
  wire [0:0]S00_ARESETN_1;
  wire [31:0]m00_couplers_to_microblaze_0_axi_periph_ARADDR;
  wire m00_couplers_to_microblaze_0_axi_periph_ARREADY;
  wire m00_couplers_to_microblaze_0_axi_periph_ARVALID;
  wire [31:0]m00_couplers_to_microblaze_0_axi_periph_AWADDR;
  wire m00_couplers_to_microblaze_0_axi_periph_AWREADY;
  wire m00_couplers_to_microblaze_0_axi_periph_AWVALID;
  wire m00_couplers_to_microblaze_0_axi_periph_BREADY;
  wire [1:0]m00_couplers_to_microblaze_0_axi_periph_BRESP;
  wire m00_couplers_to_microblaze_0_axi_periph_BVALID;
  wire [31:0]m00_couplers_to_microblaze_0_axi_periph_RDATA;
  wire m00_couplers_to_microblaze_0_axi_periph_RREADY;
  wire [1:0]m00_couplers_to_microblaze_0_axi_periph_RRESP;
  wire m00_couplers_to_microblaze_0_axi_periph_RVALID;
  wire [31:0]m00_couplers_to_microblaze_0_axi_periph_WDATA;
  wire m00_couplers_to_microblaze_0_axi_periph_WREADY;
  wire [3:0]m00_couplers_to_microblaze_0_axi_periph_WSTRB;
  wire m00_couplers_to_microblaze_0_axi_periph_WVALID;
  wire [31:0]m01_couplers_to_microblaze_0_axi_periph_ARADDR;
  wire [2:0]m01_couplers_to_microblaze_0_axi_periph_ARPROT;
  wire m01_couplers_to_microblaze_0_axi_periph_ARREADY;
  wire m01_couplers_to_microblaze_0_axi_periph_ARVALID;
  wire [31:0]m01_couplers_to_microblaze_0_axi_periph_AWADDR;
  wire [2:0]m01_couplers_to_microblaze_0_axi_periph_AWPROT;
  wire m01_couplers_to_microblaze_0_axi_periph_AWREADY;
  wire m01_couplers_to_microblaze_0_axi_periph_AWVALID;
  wire m01_couplers_to_microblaze_0_axi_periph_BREADY;
  wire [1:0]m01_couplers_to_microblaze_0_axi_periph_BRESP;
  wire m01_couplers_to_microblaze_0_axi_periph_BVALID;
  wire [31:0]m01_couplers_to_microblaze_0_axi_periph_RDATA;
  wire m01_couplers_to_microblaze_0_axi_periph_RREADY;
  wire [1:0]m01_couplers_to_microblaze_0_axi_periph_RRESP;
  wire m01_couplers_to_microblaze_0_axi_periph_RVALID;
  wire [31:0]m01_couplers_to_microblaze_0_axi_periph_WDATA;
  wire m01_couplers_to_microblaze_0_axi_periph_WREADY;
  wire [3:0]m01_couplers_to_microblaze_0_axi_periph_WSTRB;
  wire m01_couplers_to_microblaze_0_axi_periph_WVALID;
  wire [31:0]m02_couplers_to_microblaze_0_axi_periph_ARADDR;
  wire [2:0]m02_couplers_to_microblaze_0_axi_periph_ARPROT;
  wire [0:0]m02_couplers_to_microblaze_0_axi_periph_ARREADY;
  wire [0:0]m02_couplers_to_microblaze_0_axi_periph_ARVALID;
  wire [31:0]m02_couplers_to_microblaze_0_axi_periph_AWADDR;
  wire [2:0]m02_couplers_to_microblaze_0_axi_periph_AWPROT;
  wire [0:0]m02_couplers_to_microblaze_0_axi_periph_AWREADY;
  wire [0:0]m02_couplers_to_microblaze_0_axi_periph_AWVALID;
  wire [0:0]m02_couplers_to_microblaze_0_axi_periph_BREADY;
  wire [1:0]m02_couplers_to_microblaze_0_axi_periph_BRESP;
  wire [0:0]m02_couplers_to_microblaze_0_axi_periph_BVALID;
  wire [31:0]m02_couplers_to_microblaze_0_axi_periph_RDATA;
  wire [0:0]m02_couplers_to_microblaze_0_axi_periph_RREADY;
  wire [1:0]m02_couplers_to_microblaze_0_axi_periph_RRESP;
  wire [0:0]m02_couplers_to_microblaze_0_axi_periph_RVALID;
  wire [31:0]m02_couplers_to_microblaze_0_axi_periph_WDATA;
  wire [0:0]m02_couplers_to_microblaze_0_axi_periph_WREADY;
  wire [3:0]m02_couplers_to_microblaze_0_axi_periph_WSTRB;
  wire [0:0]m02_couplers_to_microblaze_0_axi_periph_WVALID;
  wire [31:0]m03_couplers_to_microblaze_0_axi_periph_ARADDR;
  wire [2:0]m03_couplers_to_microblaze_0_axi_periph_ARPROT;
  wire m03_couplers_to_microblaze_0_axi_periph_ARREADY;
  wire m03_couplers_to_microblaze_0_axi_periph_ARVALID;
  wire [31:0]m03_couplers_to_microblaze_0_axi_periph_AWADDR;
  wire [2:0]m03_couplers_to_microblaze_0_axi_periph_AWPROT;
  wire m03_couplers_to_microblaze_0_axi_periph_AWREADY;
  wire m03_couplers_to_microblaze_0_axi_periph_AWVALID;
  wire m03_couplers_to_microblaze_0_axi_periph_BREADY;
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
  wire [1:0]s00_couplers_to_xbar_BRESP;
  wire [0:0]s00_couplers_to_xbar_BVALID;
  wire [31:0]s00_couplers_to_xbar_RDATA;
  wire [0:0]s00_couplers_to_xbar_RREADY;
  wire [1:0]s00_couplers_to_xbar_RRESP;
  wire [0:0]s00_couplers_to_xbar_RVALID;
  wire [31:0]s00_couplers_to_xbar_WDATA;
  wire [0:0]s00_couplers_to_xbar_WREADY;
  wire [3:0]s00_couplers_to_xbar_WSTRB;
  wire [0:0]s00_couplers_to_xbar_WVALID;
  wire [31:0]xbar_to_m00_couplers_ARADDR;
  wire xbar_to_m00_couplers_ARREADY;
  wire [0:0]xbar_to_m00_couplers_ARVALID;
  wire [31:0]xbar_to_m00_couplers_AWADDR;
  wire xbar_to_m00_couplers_AWREADY;
  wire [0:0]xbar_to_m00_couplers_AWVALID;
  wire [0:0]xbar_to_m00_couplers_BREADY;
  wire [1:0]xbar_to_m00_couplers_BRESP;
  wire xbar_to_m00_couplers_BVALID;
  wire [31:0]xbar_to_m00_couplers_RDATA;
  wire [0:0]xbar_to_m00_couplers_RREADY;
  wire [1:0]xbar_to_m00_couplers_RRESP;
  wire xbar_to_m00_couplers_RVALID;
  wire [31:0]xbar_to_m00_couplers_WDATA;
  wire xbar_to_m00_couplers_WREADY;
  wire [3:0]xbar_to_m00_couplers_WSTRB;
  wire [0:0]xbar_to_m00_couplers_WVALID;
  wire [63:32]xbar_to_m01_couplers_ARADDR;
  wire [5:3]xbar_to_m01_couplers_ARPROT;
  wire xbar_to_m01_couplers_ARREADY;
  wire [1:1]xbar_to_m01_couplers_ARVALID;
  wire [63:32]xbar_to_m01_couplers_AWADDR;
  wire [5:3]xbar_to_m01_couplers_AWPROT;
  wire xbar_to_m01_couplers_AWREADY;
  wire [1:1]xbar_to_m01_couplers_AWVALID;
  wire [1:1]xbar_to_m01_couplers_BREADY;
  wire [1:0]xbar_to_m01_couplers_BRESP;
  wire xbar_to_m01_couplers_BVALID;
  wire [31:0]xbar_to_m01_couplers_RDATA;
  wire [1:1]xbar_to_m01_couplers_RREADY;
  wire [1:0]xbar_to_m01_couplers_RRESP;
  wire xbar_to_m01_couplers_RVALID;
  wire [63:32]xbar_to_m01_couplers_WDATA;
  wire xbar_to_m01_couplers_WREADY;
  wire [7:4]xbar_to_m01_couplers_WSTRB;
  wire [1:1]xbar_to_m01_couplers_WVALID;
  wire [95:64]xbar_to_m02_couplers_ARADDR;
  wire [8:6]xbar_to_m02_couplers_ARPROT;
  wire [0:0]xbar_to_m02_couplers_ARREADY;
  wire [2:2]xbar_to_m02_couplers_ARVALID;
  wire [95:64]xbar_to_m02_couplers_AWADDR;
  wire [8:6]xbar_to_m02_couplers_AWPROT;
  wire [0:0]xbar_to_m02_couplers_AWREADY;
  wire [2:2]xbar_to_m02_couplers_AWVALID;
  wire [2:2]xbar_to_m02_couplers_BREADY;
  wire [1:0]xbar_to_m02_couplers_BRESP;
  wire [0:0]xbar_to_m02_couplers_BVALID;
  wire [31:0]xbar_to_m02_couplers_RDATA;
  wire [2:2]xbar_to_m02_couplers_RREADY;
  wire [1:0]xbar_to_m02_couplers_RRESP;
  wire [0:0]xbar_to_m02_couplers_RVALID;
  wire [95:64]xbar_to_m02_couplers_WDATA;
  wire [0:0]xbar_to_m02_couplers_WREADY;
  wire [11:8]xbar_to_m02_couplers_WSTRB;
  wire [2:2]xbar_to_m02_couplers_WVALID;
  wire [127:96]xbar_to_m03_couplers_ARADDR;
  wire [11:9]xbar_to_m03_couplers_ARPROT;
  wire xbar_to_m03_couplers_ARREADY;
  wire [3:3]xbar_to_m03_couplers_ARVALID;
  wire [127:96]xbar_to_m03_couplers_AWADDR;
  wire [11:9]xbar_to_m03_couplers_AWPROT;
  wire xbar_to_m03_couplers_AWREADY;
  wire [3:3]xbar_to_m03_couplers_AWVALID;
  wire [3:3]xbar_to_m03_couplers_BREADY;
  wire [1:0]xbar_to_m03_couplers_BRESP;
  wire xbar_to_m03_couplers_BVALID;
  wire [31:0]xbar_to_m03_couplers_RDATA;
  wire [3:3]xbar_to_m03_couplers_RREADY;
  wire [1:0]xbar_to_m03_couplers_RRESP;
  wire xbar_to_m03_couplers_RVALID;
  wire [127:96]xbar_to_m03_couplers_WDATA;
  wire xbar_to_m03_couplers_WREADY;
  wire [15:12]xbar_to_m03_couplers_WSTRB;
  wire [3:3]xbar_to_m03_couplers_WVALID;
  wire [159:128]xbar_to_m04_couplers_ARADDR;
  wire xbar_to_m04_couplers_ARREADY;
  wire [4:4]xbar_to_m04_couplers_ARVALID;
  wire [159:128]xbar_to_m04_couplers_AWADDR;
  wire xbar_to_m04_couplers_AWREADY;
  wire [4:4]xbar_to_m04_couplers_AWVALID;
  wire [4:4]xbar_to_m04_couplers_BREADY;
  wire [1:0]xbar_to_m04_couplers_BRESP;
  wire xbar_to_m04_couplers_BVALID;
  wire [31:0]xbar_to_m04_couplers_RDATA;
  wire [4:4]xbar_to_m04_couplers_RREADY;
  wire [1:0]xbar_to_m04_couplers_RRESP;
  wire xbar_to_m04_couplers_RVALID;
  wire [159:128]xbar_to_m04_couplers_WDATA;
  wire xbar_to_m04_couplers_WREADY;
  wire [19:16]xbar_to_m04_couplers_WSTRB;
  wire [4:4]xbar_to_m04_couplers_WVALID;
  wire [191:160]xbar_to_m05_couplers_ARADDR;
  wire xbar_to_m05_couplers_ARREADY;
  wire [5:5]xbar_to_m05_couplers_ARVALID;
  wire [191:160]xbar_to_m05_couplers_AWADDR;
  wire xbar_to_m05_couplers_AWREADY;
  wire [5:5]xbar_to_m05_couplers_AWVALID;
  wire [5:5]xbar_to_m05_couplers_BREADY;
  wire [1:0]xbar_to_m05_couplers_BRESP;
  wire xbar_to_m05_couplers_BVALID;
  wire [31:0]xbar_to_m05_couplers_RDATA;
  wire [5:5]xbar_to_m05_couplers_RREADY;
  wire [1:0]xbar_to_m05_couplers_RRESP;
  wire xbar_to_m05_couplers_RVALID;
  wire [191:160]xbar_to_m05_couplers_WDATA;
  wire xbar_to_m05_couplers_WREADY;
  wire [23:20]xbar_to_m05_couplers_WSTRB;
  wire [5:5]xbar_to_m05_couplers_WVALID;
  wire [223:192]xbar_to_m06_couplers_ARADDR;
  wire [20:18]xbar_to_m06_couplers_ARPROT;
  wire xbar_to_m06_couplers_ARREADY;
  wire [6:6]xbar_to_m06_couplers_ARVALID;
  wire [223:192]xbar_to_m06_couplers_AWADDR;
  wire [20:18]xbar_to_m06_couplers_AWPROT;
  wire xbar_to_m06_couplers_AWREADY;
  wire [6:6]xbar_to_m06_couplers_AWVALID;
  wire [6:6]xbar_to_m06_couplers_BREADY;
  wire xbar_to_m06_couplers_BRESP;
  wire xbar_to_m06_couplers_BVALID;
  wire xbar_to_m06_couplers_RDATA;
  wire [6:6]xbar_to_m06_couplers_RREADY;
  wire xbar_to_m06_couplers_RRESP;
  wire xbar_to_m06_couplers_RVALID;
  wire [223:192]xbar_to_m06_couplers_WDATA;
  wire xbar_to_m06_couplers_WREADY;
  wire [27:24]xbar_to_m06_couplers_WSTRB;
  wire [6:6]xbar_to_m06_couplers_WVALID;
  wire [255:224]xbar_to_m07_couplers_ARADDR;
  wire [0:0]xbar_to_m07_couplers_ARREADY;
  wire [7:7]xbar_to_m07_couplers_ARVALID;
  wire [255:224]xbar_to_m07_couplers_AWADDR;
  wire [0:0]xbar_to_m07_couplers_AWREADY;
  wire [7:7]xbar_to_m07_couplers_AWVALID;
  wire [7:7]xbar_to_m07_couplers_BREADY;
  wire [1:0]xbar_to_m07_couplers_BRESP;
  wire [0:0]xbar_to_m07_couplers_BVALID;
  wire [31:0]xbar_to_m07_couplers_RDATA;
  wire [7:7]xbar_to_m07_couplers_RREADY;
  wire [1:0]xbar_to_m07_couplers_RRESP;
  wire [0:0]xbar_to_m07_couplers_RVALID;
  wire [255:224]xbar_to_m07_couplers_WDATA;
  wire [0:0]xbar_to_m07_couplers_WREADY;
  wire [31:28]xbar_to_m07_couplers_WSTRB;
  wire [7:7]xbar_to_m07_couplers_WVALID;
  wire [287:256]xbar_to_m08_couplers_ARADDR;
  wire xbar_to_m08_couplers_ARREADY;
  wire [8:8]xbar_to_m08_couplers_ARVALID;
  wire [287:256]xbar_to_m08_couplers_AWADDR;
  wire xbar_to_m08_couplers_AWREADY;
  wire [8:8]xbar_to_m08_couplers_AWVALID;
  wire [8:8]xbar_to_m08_couplers_BREADY;
  wire [1:0]xbar_to_m08_couplers_BRESP;
  wire xbar_to_m08_couplers_BVALID;
  wire [31:0]xbar_to_m08_couplers_RDATA;
  wire [8:8]xbar_to_m08_couplers_RREADY;
  wire [1:0]xbar_to_m08_couplers_RRESP;
  wire xbar_to_m08_couplers_RVALID;
  wire [287:256]xbar_to_m08_couplers_WDATA;
  wire xbar_to_m08_couplers_WREADY;
  wire [35:32]xbar_to_m08_couplers_WSTRB;
  wire [8:8]xbar_to_m08_couplers_WVALID;
  wire [319:288]xbar_to_m09_couplers_ARADDR;
  wire xbar_to_m09_couplers_ARREADY;
  wire [9:9]xbar_to_m09_couplers_ARVALID;
  wire [319:288]xbar_to_m09_couplers_AWADDR;
  wire xbar_to_m09_couplers_AWREADY;
  wire [9:9]xbar_to_m09_couplers_AWVALID;
  wire [9:9]xbar_to_m09_couplers_BREADY;
  wire [1:0]xbar_to_m09_couplers_BRESP;
  wire xbar_to_m09_couplers_BVALID;
  wire [31:0]xbar_to_m09_couplers_RDATA;
  wire [9:9]xbar_to_m09_couplers_RREADY;
  wire [1:0]xbar_to_m09_couplers_RRESP;
  wire xbar_to_m09_couplers_RVALID;
  wire [319:288]xbar_to_m09_couplers_WDATA;
  wire xbar_to_m09_couplers_WREADY;
  wire [39:36]xbar_to_m09_couplers_WSTRB;
  wire [9:9]xbar_to_m09_couplers_WVALID;
  wire [351:320]xbar_to_m10_couplers_ARADDR;
  wire xbar_to_m10_couplers_ARREADY;
  wire [10:10]xbar_to_m10_couplers_ARVALID;
  wire [351:320]xbar_to_m10_couplers_AWADDR;
  wire xbar_to_m10_couplers_AWREADY;
  wire [10:10]xbar_to_m10_couplers_AWVALID;
  wire [10:10]xbar_to_m10_couplers_BREADY;
  wire [1:0]xbar_to_m10_couplers_BRESP;
  wire xbar_to_m10_couplers_BVALID;
  wire [31:0]xbar_to_m10_couplers_RDATA;
  wire [10:10]xbar_to_m10_couplers_RREADY;
  wire [1:0]xbar_to_m10_couplers_RRESP;
  wire xbar_to_m10_couplers_RVALID;
  wire [351:320]xbar_to_m10_couplers_WDATA;
  wire xbar_to_m10_couplers_WREADY;
  wire [43:40]xbar_to_m10_couplers_WSTRB;
  wire [10:10]xbar_to_m10_couplers_WVALID;
  wire [383:352]xbar_to_m11_couplers_ARADDR;
  wire [35:33]xbar_to_m11_couplers_ARPROT;
  wire xbar_to_m11_couplers_ARREADY;
  wire [11:11]xbar_to_m11_couplers_ARVALID;
  wire [383:352]xbar_to_m11_couplers_AWADDR;
  wire [35:33]xbar_to_m11_couplers_AWPROT;
  wire xbar_to_m11_couplers_AWREADY;
  wire [11:11]xbar_to_m11_couplers_AWVALID;
  wire [11:11]xbar_to_m11_couplers_BREADY;
  wire xbar_to_m11_couplers_BRESP;
  wire xbar_to_m11_couplers_BVALID;
  wire xbar_to_m11_couplers_RDATA;
  wire [11:11]xbar_to_m11_couplers_RREADY;
  wire xbar_to_m11_couplers_RRESP;
  wire xbar_to_m11_couplers_RVALID;
  wire [383:352]xbar_to_m11_couplers_WDATA;
  wire xbar_to_m11_couplers_WREADY;
  wire [47:44]xbar_to_m11_couplers_WSTRB;
  wire [11:11]xbar_to_m11_couplers_WVALID;
  wire [35:0]NLW_xbar_m_axi_arprot_UNCONNECTED;
  wire [35:0]NLW_xbar_m_axi_awprot_UNCONNECTED;
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
